vivian-ng/Hardware/README.md

# Hardware

Repository of all hardware related files, including schematics, gerber files, and related software.
