vivian-ng/Hardware/(threads)

Thread 1 (2018-12-12):

Feedback on MRR_ESP_3DP

vivian-ng, 2018-12-12:
Please give any feedback on the board design (schematic and PCB) on this thread.

vivian-ng, 2018-12-13:
@dtony Thank you for the note about SPI, unfortunately, I do not have much experience with TMC2130 drivers, so if you have any information on what are the pins needed and other information on what is needed to drive them, I can try to see how I can fit it in.

vivian-ng, 2018-12-14:
@dtony I did a bit of searching on Google, and I think I have an idea of what it takes to connect the TMC drivers (2130 and 2208, SPI and UART). What I am doing now is adding some jumpers (actually, quite a lot of them) to allow the board to be configured for either TMC2180 SPI mode, TMC2208 UART mode, or just plain simple A4988 drivers.

However, for TMC2130 drivers, they require a separate CS pin for each driver. With the current pinout of the ESP32, there simply isn't enough pins to support 4 TMC2130 drivers running in SPI mode. Two of them (most likely X and Y) can be connected to the I2C pins (SCL and SDA) if you are not intending to use I2C. GPIO0 is also still available, but I am not very sure whether using GPIO0 for output is fine or not, since it is also used for flashing the firmware.

@simon-jouet and @Aggebitter are [talking about using shift registers](https://github.com/simon-jouet/ESP32Controller/issues/4) to increase the number of pins available. This may eventually be the way to go, but meanwhile, for a basic minimum board that can do the bare minimum, this board should be more or less there. I will push out the schematic and gerber files once I have done up the PCB design alterations.

If anyone knows how to convert EasyEDA schematics and PCB designs into KiCad, please let me know. Easier to share the designs in KiCad, which seems to be what everyone is using. I probably should start learning it too.

Aggebitter, 2018-12-14:
@vivian-ng
At last the community is starting to figure out how to use the ESP32 as a 3D printer and as a GRBL CNC machine (https://github.com/bdring/Grbl_Esp32) . At the moment I'm trying to get my small CNC router to work on ESP32 and GRBL. Now I wonder if the two different hardware layouts should be merged to a common layout where the pinout is more or less "standard" for using the easy available RAMPS 1.4 or Protoneer GRBL shields (Arduino UNO shield). I've addressed the "I2S shift register hint" at https://github.com/bdring/Grbl_Esp32 and did a quick'n dirty protoboard for GRBL_ESP32 and RAMPS 1.4.

But Now I feel that I will keep it a bit on hold course the ref design on pinouts  could be merged;)

dtony, 2018-12-14:
@vivian-ng thank you I had not the time to answer to you yet so I am glad that you'd figure it out. Wouldn't it be possible to use the freed pins from A4988 step pin or dir pin to be used as chip select ? I need to look at ESP32 datasheet to be sure but I guess it can be possible. I think keeping the BOM minimal in term of component count is a good idea but you are the captain ;)

vivian-ng, 2018-12-15:
@dtony Thanks for the feedback. From what I understand, whether TMC2130 or TMC2208, whether SPI or UART, the STEP and DIR pins are still needed for actual motor movement control. SPI or UART allows you to set modes, change microstepping, enable stallguard, etc. but they do not allow actual control of the motors. So we are still stuck with needing STEP and DIR pins for each motor.

@Aggebitter and @simon-jouet are working on the I2S shift register feature, which will allow a lot more pins to become available through shift registers. Until that happens, I think we are stuck with the number of pins available for TMC2130 on SPI mode. For TMC2208 on UART, there isn't really much of a problem since it can use the existing TX/RX ports. But I am not sure what will happen when both a host (such as PC) is connected through USB and uses the same TX/RX as the TMC2208...

vivian-ng, 2018-12-15:
@Aggebitter RAMPS 1.4 is a 5V board, so some work will be needed to mod it to allow 3.3V logic. It may be a better idea to develop a 3.3V capable RAMPS equivalent for use with common ESP32 development boards. I think @simon-jouet has done [something like that before](https://github.com/simon-jouet/ESPRamps). Meanwhile, I think I will focus on a basic board, using only the ESP32, no fancy stuff.

Aggebitter, 2018-12-15:
@vivian-ng Vcc hacked to 3.3V of course applied.
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
Found this goodie when I was looking for some proto board pieces. Hmm I'll think I will make it a ESP32 Ramps based on your design and @simon-jouet hopefully soon added shift registers

Aggebitter, 2018-12-17:
@vivian-ng I Did a first quick look into your board design and I'm building a proto/breakout/wire-wrap board based on your design right now. One issue that I noticed is that I prefer to gate MOSFET's with a transistor. This is due the fact that a MOSFET is voltage drive (as charging a capacitor). A well known design flaw in chinese RAMPS 1.4  is MOSFET's that does not open correct when driven in 5V.

A NPN transistor to drive it at higher voltage would be preferred and it will open the range for other MOSFET's as well

One thing that I really would like is a separe voltage line for driving steppers. Driving steppers at higher voltages is an big advantage and just going from 12V to 24 on a 3D-printer does magic. On My small router the difference was huge in speed  as it uses ball screws.

To day newer stepper drivers can handle 40V or more. Goal 36V ?

vivian-ng, 2018-12-17:
@Aggebitter Thank you for the feedback. I have tried to choose mosfets which can be driven by 3.3V logic but I guess driving them at 5V is better, safer, and also more efficient. A question on how to connect these transistors. I am thinking of using a 2N3904, which I guess will be connected with:
base -> HEATER_BED_PIN (and equivalent) in series with a 1K resistor (is this resistor needed?)
collector -> gate of mosfet, after the gate resistor
emitter -> ground
This also means I no longer need a resistor between gate and source of the mosfet, right?
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
As for a separate power rail for stepper motors, I can understand the logic for that, let me think about how feasible it is to add it in, given one of the considerations being to keep the footprint small. Schematic-wise, it is just a matter of connecting VMOT to a separate rail, but adding another terminal may take up more space, and as it is, the current design is barely fitting onto the 100mm by 100mm space.

Aggebitter, 2018-12-17:
I Like the KISS model, Why not just use a MOSFET driver ? here you got a non inverting one:
https://www.microchip.com/wwwproducts/en/TC4427A

Those ones are easy to integrate and will give you good switching times as well

If you go for the transistor way this design will get some ripples but that does not matter for a heater:
http://joost.damad.be/2012/09/dimming-12v-led-strip-with-mosfet-and.html

vivian-ng, 2018-12-17:
@Aggebitter I also like the KISS model. A mosfet driver seems like the easiest and best choice. But how about using a NOR gate, like in the Duet, to drive the mosfets? The Duet uses the 74HCT02.
[https://www.ti.com/lit/ds/symlink/sn74hct02.pdf](https://www.ti.com/lit/ds/symlink/sn74hct02.pdf)

By the way, for my learning, what is the problem with the current design, which is used on most boards that I see?

Aggebitter, 2018-12-17:
@vivian-ng As in open source that we all love there is also often open clone. When China started to manufacture the RAMP 1.4 The started as well to reduce there cost by using cloned parts and the cheapest available kind of replaceable part. One common problem is the MOSFET's. The gate voltage is to low for the MOSFET to open fully. That creates heat at the MOSFET. Ad that it might be a complete different silicon inside of it with the right false marking aka bad clone. This will get really hot and create some hazards.

If You are designing a good 3D controller board, I think a lot of known issues could be addressed and evolve to a better and more safe design. Some things is just for safety and I think a MOSFET driver is one of them. There is a lot of juice flowing over the MOSFET. Over heat and you got a nice PLA fire if printed out a funky box for your controller. Been there done that ;)

danielfmo, 2018-12-18:
Hi, I'm following this project very closely and I'm willing to help with what I can.
I have an Creality Ender 3 that I would love to use my spares ESP32 to replace the controller board.

Sorry for the naive question, but why have the MOSFETs onboard? Would it be preferable/easier/safer to have and external board like this one:
https://www.reprap.me/mks-mosfet-controller.html

danielfmo, 2018-12-18:
Any reason to have different values for R13 and R14? Asking because potentially both VIN and VBED are the same.

vivian-ng, 2018-12-18:
@danielfmo Thanks for showing interest in this project. And also for pointing out the R13 and R14 values. Yes, they should be the same value. Different because they used to be annotated differently (VIN used to be 12V, VBED used to be 24V) but they should both be 2.2K.

As for having an external MOSFET, it is highly recommended if you are going to be driving a lot of current to the heat bed. Still, I want to have a decent MOSFET for the heat bed on the board itself for those who wish to just use a single board, and do not have such high requirements for current. For example, those who are using this with a 12V heat bed should need less than 10A of current, and it helps to have a decent MOSFET to keep the temperature low. Most people use external MOSFETs with Chinese boards because those Chinese boards use poor quality connectors and onboard MOSFETs which then become fire hazards, forcing people to have to buy Chinese-made external MOSFETs (which cost about USD10 more than a decent MOSFET if installed on the board itself). For the Chinese manufacturers, this may help their sales, but as the end consumer, we probably want to strike a balance, keeping price low without compromising safety. Personally, if I am going to drive more than 10A, I will use an external MOSFET just to take the heat off the controller board.

Aggebitter, 2018-12-19:
@vivian-ng I'm wondering about this part :
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

Why not just use IO0 with a pullup ?:
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
It will only make a conflict when uploading firmware, and well no uploading when you are probing

vivian-ng, 2018-12-20:
@Aggebitter I believe Z_MIN is connected to GPIO15. Will that affected uploading of firmware? My understanding is that GPIO0 is the one which needs to be grounded when uploading firmware, which is why I try to avoid using IO0 for anything. But then, it probably doesn't matter, since people are unlikely to be using the printer for anything else when uploading firmware.

If you are referring to using a different pin for the Z probe instead of sharing with Z_MIN, my consideration was that the Z probe is a replacement for Z min endstop anyway, so might as well share the same pin.

Aggebitter, 2018-12-21:
@vivian-ng GPIO15 will not affect firmware upload. I was thinking about using GPIO0 at the probe pin and that would not affect firmware upload as we hopefully will not Z-probe in the same time as we are uploading firmware

Have you thought about making an "Mega/RAMPS" pinout board instead ? Then everyone could easily obtain your controller a RAMPS board and stepper drivers for an easy setup?

I've already builded one proto board that uses RAMPS 1..4 but I'd like to design one later that includes 3.3 to 5V level shifting. That's my learning KiCAD challenge

vivian-ng, 2018-12-21:
@Aggebitter

> Have you thought about making an "Mega/RAMPS" pinout board instead ? Then everyone could easily obtain your controller a RAMPS board and stepper drivers for an easy setup?

That's basically a ESP32 on a MEGA2560 dev board layout. I guess it is not that difficult to design. Just a ESP32 module, a circuit for the CH340, circuit to step down 5V to 3.3V, and level shifters for all GPIO pins. Plus a ton of unused header pins. :sweat_smile:

However, that won't solve the problem with poorly cloned RAMPS boards. Still, it is a good idea, and like you, I may use this as my learning KiCad experience (I want to move away from EasyEDA, which is good but the file format it exports in is not easily readable by other software).

luc-github, 2018-12-21:
@vivian-ng you said put header for Nextion like screen / PanelDue which use rx/tx,
 what happen when an host is also connected to usbserial ?
Does this disable rx/tx like is some others boards ?

Aggebitter, 2018-12-21:
@vivian-ng The unused pins on RAMPS is mostly for screens in an already controller heavy display. If we get the shift register to work we have a lot of unshifted GPIO left on the ESP32 and outputs for servos and everything else

vivian-ng, 2018-12-21:
@luc-github

> what happen when an host is also connected to usbserial ?
> Does this disable rx/tx on header like is done on some others boards ?

Unfortunately, no, all TX/RX takes place on the same two pins, whether they are from USB, AUX1 connector, or TMC2208. Unlike other 32-bit boards, or boards based on the ATMEGA2560, the ESP32 just doesn't have enough pins to support more than 1 set of TX/RX. Of course, this may eventually change if @simon-jouet and @Aggebitter get shift registers to work via I2S as output pins.

@Aggebitter Regarding the idea for use with RAMPS, SparkFun has a [bidirectional level shifter](https://www.sparkfun.com/products/12009) which can help with digital shifting. The idea seems to be two resistors and a transistor, and this circuit is just going to be duplicated for each pin that needs level shifting. However, I am not sure how to go about analog shifting (which I guess is only needed for inputs on VP and VN pins, right?). This ESP32-on-MEGA2560-footprint board probably will have a lot of the space taken up by level shifters, and shift registers (eventually).

Meanwhile, I will focus on getting this basic ESP32-based control board out first. It is not much, but at least it has all the minimum requirements to print something. Will be getting a PCB made soon so that I can solder together something and test it with @luc-github's Marlin fork.

vivian-ng, 2018-12-28:
@Aggebitter I am not very sure how to do this, but I am guessing you mean the signal pin being connected to a voltage divider (any suggestions on the values to use? 10K for both?) as well as a capacitor (100nF?). This is going to be tricky as it will mean adding 6 resistors and 3 capacitors to the board, where space is limited. But I will see what I can do.

As for the suggestion on using transistors, if you have an example diagram of how to do this, it will really help my understanding.

Also, how bad is the noise that you are experiencing? Are the endstops being triggered just be the motors moving?

danielfmo, 2018-12-28:
@Aggebitter why not have the debounce outside of this board/project?

If I understood correctly the goal of this project is to have something that everyone can use to give a try with ESP32. And I'm not aware of other hardware that already have the debounce circuit integrated (3d printing wise).

Off-course that I'm not against it! It's that I think its a very simple circuit that one that needs it can have on an external homemade PCB.

vivian-ng, 2018-12-28:
@Aggebitter
Thank you for the diagram. Can we just do with R3, R4, and Q1? Because [mechanical endstops](https://www.aliexpress.com/item/Endstop-Mechanical-Limit-Switches-3D-Printer-Switch-for-RAMPS-1-4-Free-Shipping-Dropshipping/32434789705.html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,searchweb201602_4_10065_10068_319_10059_10884_317_10887_10696_100031_321_322_10084_453_10083_454_10103_10618_10307_538_537_536,searchweb201603_51,ppcSwitch_0&algo_expid=e3e11c45-5e92-4250-abcd-c34e2cb8b569-1&algo_pvid=e3e11c45-5e92-4250-abcd-c34e2cb8b569) are already being sold with their own debouncing circuits. I guess R1, R2, and C1 will only be necessary if you are just using a plain mechanical switch. Space is an issue, I am trying to keep the circuits simple. Something this elaborate may be functionally great, but my fear is that it will drive the cost of producing it up and make it hard for people to get their hands on one. If the board goes larger than 100mm by 100mm, people cannot make use of cheap PCB services (like the USD2.00 offer from JLCPCB).
The other option I am thinking of is to just have a simple debouncing circuit, with 2 resistors and 1 capacitor, like what is on the Duet. If I do go this way, I will likely use a resistor array to keep the footprint small and see if I can squeeze it in.

@danielfmo
Actually, the Duet, Smoothieboard, and STEVAL-3DP have debouncing circuits on them. They are probably necessary on 3.3V boards using plain mechanical switches as endstops. Chinese boards like the FYTSEC F6 do not have them, but I guess they expect people to use mechanical endstops (with debouncing circuit already built in) with these boards in the first place.
If I cannot fit 3 sets of debouncing circuits on the PCB, I guess I will make a note in the README to use mechanical endstops with built-in circuits.

Aggebitter, 2018-12-28:
@vivian-ng @danielfmo Well, I was thinking when doing 3.3V signaling, that it must have some good filtering and debounce to reduce false triggering. Especially when the steppers are driven at higher voltages. This is cheap and will help a lot

vivian-ng, 2018-12-29:
After looking at the PCB, I think I will add the bare minimum: capacitors as filters for the endstops. The entire setup with more resistors and transistors is probably an ideal state, but it is going to be hard to squeeze into the limited real estate available.
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

Hopefully this is enough to cut down on most of the noise.

Once this basic version is done, I may work on a R2 with this better filter and also incorporate shift registers for additional output IOs. And use smaller SMD parts to make space.

vivian-ng, 2019-01-07:
I finally managed to solder together v0.6 using a frying pan. Flashed the latest version of Luc's Marlin fork, and the web UI is working. Next is to actually connect it to a printer to see if this works. This will take a while since I will be busy over the next few days with work, but I will try to see what I can do to test it out this week.

Meanwhile, v0.7 is already in the works, incorporating the suggestions from everyone. v0.7 will reflect any other changes needed based on testing of v0.6. One update: TMC2208 support will be removed from v0.7 onward as there are not enough sets of TX/RX pins for a meaningful implementation (need 4 pins to implement X and Y at the very least). Maybe when I2S is working and we have more pins available, TMC2208 support will appear again in R2.

vivian-ng, 2019-01-09:
After nearly burning the house down, I realized the LM2596-5.0 was not outputting 5.0V. It was giving more like 5.8V. This caused the 74HCT02 to fail, resulting in voltage being fed continuously to the MOSFETs (one of which I had a hotend attached to).

A few options:
1. Add a 5V regulator to make sure the input to 74HCT02 is always 5V or less.
2. Change to another NOR gate which can accept a higher VCC.
3. Change to a better 5V step-down converter which can provide accurate 5V output.

Option 1 is the easiest, and I will likely be adopting it as I:
a. Do not know any suitable replacements for the 74HCT02 which can handle higher voltages.
b. Do not know any suitable replacements for the LM2596 which can be assured of providing accurate 5V.

If anyone has any better suggestions, please let me know!

Meanwhile, I have removed the 74HCT02 from the board, and used wires to connect the MOSFETs to their respective ESP32 pins.
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

vivian-ng, 2019-01-10:
I think I narrowed down the problem with the high output voltage of the LM2596S-5.0. Stupid me chose the wrong inductor when I was designing on EasyEDA. While the schematic doesn't show it, the inductor being used in v0.6 is rated for a much smaller current (540mA) than recommended. I guess that's why I couldn't get the LM2596S-5.0 to deliver proper 5V. Still, it does expose the flaw of using the 74HCT02 (which can use a max supply of 5.5V) so I will replace that with a 74HCT125.

The next version will likely also include using an opamp to select 5V (either from VIN or VUSB) like on the Arduino UNO R3 board instead of jumpers. Too risky to use jumpers and hope the user remembers to set the jumpers correctly.

dtony, 2019-01-10:
Nice board ! :) What do you think of having jumpers to switch from X, Y or Z endstops to SPI CS_PIN of TMC2130 ? For the extruder controller I don't know which pin could be used as default.

vivian-ng, 2019-01-11:
Just uploaded the files for v0.7. Major changes are the use of 74HCT126 (non-inverting buffer gate) to drive the MOSFETs instead. And a revamp of the 5V step-down circuit to use the TPS54340 instead of the LM2596 for a smaller footprint. The amount of space freed up will eventually be used to add two 74HC595 for I2S driving of the motors (and maybe even MOSFETs).

I will probably order the PCB from JLCPCB again soon and give it another go. Hopefully this design works and I can upgrade it to v1.0 before Chinese New Year, because it is going to be hard to get parts or PCB during Chinese New Year period with all the Chinese companies taking a break. But that also means if I can get v0.7 PCB done by Chinese New Year, I can spend that period testing it and make any necessary (hopefully none) changes.

Aggebitter, 2019-01-19:
@vivian-ng, Simon has the I2S running know so some shift register as the next step ?

vivian-ng, 2019-01-20:
@Aggebitter
Yes, shift register is the next step, but as mentioned, I want to get a version which can just run Marlin 2.0 as it is now. I think I am almost there. v0.8 will be removing 74HCT125 and some headers to make space for 74HC595 registers. The plan is to put two on the board itself (which should be enough to drive 4 steppers), and a breakout of the latch pin to allow connection to a daughter board. The daughter board will include another two 74HC595s plus circuitry to support another 4 steppers.

Why?
This allows people who just need a basic board to use the base board itself. Those who need additional steppers (multi-extrusion, dual Z, etc,) can then have the daughter board option. I already have an idea on how to design the board (components and layout), all I need now is time, and for Marlin to pull Simon's code officially into 2.0 branch.

Meanwhile, let me get a proper v1.0 out first.

vivian-ng, 2019-01-31:
I have renamed the project in preparation for a v1.0 release to give it more identity. Future discussions on the project should be on this [thread](https://github.com/vivian-ng/Hardware/issues/2).

Meanwhile, v0.8 is on KiCad, and the files will be released on GitHub soon.

BTW, v1.0 will still just be a basic board, no I2S. But space has been allocated for I2S, which I will get down to working on once v1.0 is out.

vivian-ng, 2019-09-17:
I have finally managed to find a PCB manufacturer to get a proper quote. I have launched this project on Kickstarter based on the quote to make it available to everyone who wants one but do not have the time/resources to make one themselves. The reward is priced at cost: 76.5% production and shipping, 5% Kickstarter fees, 4.5% Kickstarter payment provider fees, 6% bank fees, 8% taxes.

For those who already have the required components on hand, making your own board by ordering a PCB (from JLCPCB, for example) is the cheaper option. But for those with no such components, I think backing this Kickstarter is the easy (and cheaper) way since the unit price is based on a larger production volume.

Anyway, here is the link:
[MRR ESPA Kickstarter page](https://www.kickstarter.com/projects/maplerainresearch/mrr-espa)

Closed 2019-09-17.

Thread 2 (2019-01-31):

Feedback on MRR ESPA

vivian-ng, 2019-01-31:
Opening a new issue thread to track feedback for the MRR ESPA.

MRR ESPA is the rename of MRR ESP 3DP. The files for MRR ESP 3DP have been migrated to KiCad for v0.8 and those files will be released on GitHub soon. Meanwhile, in preparation for a proper v1.0 release, I have renamed the board to try and give it some identity. :smile:

MRR ESPA v0.9 will be up on GitHub as soon as I can sort it out. File will be on KiCad so that everyone and modify them easily. All symbols and footprints are either from the generic KiCad libraries, or inside a custom library included with the project. You may need to adjust the paths a bit on your system in order to properly find those files. They are in the subdirectory `projlib` with the footprints in `projfp.pretty` and symbols in `projsym.lib`.

The biggest difference between MRR ESPA v0.9 and MRR ESP 3DP v0.8 would be the separation of the VBED rail. It has been isolated from the VIN rail so that they no longer share a common ground line. This means two different PSUs can be used to power VIN and VBED. This is achieved using an optocoupler to drive the bed MOSFET's gate. A voltage divider to half the VBED voltage is the voltage used to drive the MOSFET. I may want to change this to something closer to one-third; but then, it is easily changed by the end user to whatever ratio they want: just solder the corresponding values of resistors instead of the one given in the schematic.

Will upload the files once I can.

vivian-ng, 2019-02-06:
Migrating to KiCad ended up in quite a few mistakes. C11 and C12 of v0.8 were connected wrongly, resulting in 5V not going to the 3.3V LDO, and 3.3V not going to the CH340C. These can be fixed by soldering through-hole capacitors in place of these SMD capacitors. Also, the collector and emitter of the S9014 for Q5 needs to be swapped. Again, this can be done by using a through-hole NPN transistor.

The 5V autoselect circuit also didn't seem to want to work. So I just soldered diodes to prevent backflow.

After making these changes (capacitors C11 & C12, Q5, and the diodes to VUSB and 5V1), the board works! However, because IO2 is pulled high, the board cannot be flashed solely with USB. I needed to connect IO2 to GND (via the header pins), reset the board to enter flash mode. Once that is done, the board can be flashed. The next step is to test the motors and MOSFETs. Hopefully, I don't burn anything.

vivian-ng, 2019-02-18:
I am having some issues trying to compile Marlin 2.0 with TMC2130 for X and Y axes.

`In file included from /tmp/arduino_build_501088/sketch/src/module/../inc/MarlinConfig.h:45:0,
                 from /tmp/arduino_build_501088/sketch/src/module/configuration_store.h:26,
                 from /tmp/arduino_build_501088/sketch/src/module/configuration_store.cpp:47:
/tmp/arduino_build_501088/sketch/src/module/configuration_store.cpp: In function 'void say_M906()':
/tmp/arduino_build_501088/sketch/src/module/configuration_store.cpp:1926:52: error: 'port' was not declared in this scope
     void say_M906(PORTARG_SOLO) { SERIAL_ECHOPGM_P(port, "  M906"); }
                                                    ^
/tmp/arduino_build_501088/sketch/src/module/../inc/../core/serial.h:81:69: note: in definition of macro 'SERIAL_PROTOCOLPGM_P'
   #define SERIAL_PROTOCOLPGM_P(p,x)               (serialprintPGM_P(p,PSTR(x)))
                                                                     ^
/tmp/arduino_build_501088/sketch/src/module/configuration_store.cpp:1926:35: note: in expansion of macro 'SERIAL_ECHOPGM_P'
     void say_M906(PORTARG_SOLO) { SERIAL_ECHOPGM_P(port, "  M906"); }`

I am not really sure how to fix this on Marlin, don't even know if Marlin 2.0's TMC2130 support can even run on the ESP32, so I will leave the hardware option available for the time being while someone eventually works out a software solution to it. Meanwhile, the TMC2130 support on this board will continue to be listed as "Untested" so that people know it is something to be implemented software-wise.

vivian-ng, 2019-03-04:
Update on v0.9.

Soldered everything, and compiled @luc-github Marlin fork which has his ESP3D interface. Prelim tests show that the compile went okay, I could drive the motors to move using the webUI. I attached a heating block with thermistor to simulate the heat bed, and it was able to heat up too, so at least the optocoupler seems to be working. E0 also heated up.

Only thing that seems to be the problem is AUX1. I can't seem to get my MKS TFT32 to work with the board via AUX1. And in the process, I think I fried my RX and TX pins on the ESP32... so while I can see serial messages on the webUI, I can no longer connect to the board with a wired connection (USB or USB<->Serial module) to see serial messages.

Next step is to find time to wire v0.9 to an actual printer to try some test prints, as well as a stress test (dry-print something for 24 hours or more) if the test prints come out okay. Once everything is working, then I will go back to troubleshooting the MKS TFT32 connection (which probably means I need to solder a new board; good thing I ordered 5 pieces).

Meanwhile, v0.9 files will be released soon. It will be accompanied by a sorting of the directory structure, so let me think through the new directory structure first.

vivian-ng, 2019-03-18:
Update on v0.9.

The files have been uploaded to the repo under the `current` directory.

Theoretically, v0.9 works as long as you are using external MOSFETs for the bed and hotend. During my testing, I discovered that the traces for the bed and hotend MOSFETs were too thin and also the via connecting top and bottom traces were too small. This causes heat buildup, melts the PCB, and gives off smoke. Not a great thing to do. But with external MOSFETs, the current is taken off the board, so the design works as it is.
BTW, if anyone wants to try out v0.9 using external MOSFETs, you can do away with the bed and hotend MOSFETs onboard to save cost. Just use jumper wires to connect IO2 (hotend), IO4 (bed), and GND (can take from AUX1) to their respective external MOSFETs. Of course, you can leave them in and still use them to drive the external MOSFET.

Also tested motor movement using A4988 drivers, which worked fine. I had issues compiling the webui-enabled Marlin fork by @luc-github using TMC2130 drivers, as mentioned above, but when I used the latest bugsfix-2.0.x from the main Marlin repo, I could compile TMC2130 support with no issue using the [TMCStepper library](https://github.com/teemuatlut/TMCStepper). So theoretically, TMC2130 in SPI mode should work too, although I will need to find time to test this (eventually...)

Also theoretically, TMC2130 and TMC2208 drivers should work in standalone mode if the jumpers underneath the stepstick are removed (MS1 and MS2 must both be tied to VIO to enable 1/16 microstepping). I just ordered two each and will test them when they arrive in a few weeks time.

Way ahead:
I am working on the MOSFET trace issue, and will work on the TMC2130/TMC2208 jumpers to allow them to be used for standalone mode (same 3-pin jumpers, with connections to GND and VIO). The next version of this board will not have the current "use jumpers to configure for TMC2130 SPI" feature. SPI pins are already exposed, so future versions of this board will support standalone mode via jumpers, and SPI mode with the "top-facing pins" method used in most other boards.

The next version of this board should be the "production" version. Once it is done and tested to be respectably working fine, I am going to move to add the I2S support. But will need to check with @simon-jouet on what his I2S setup is like.

daboi, 2019-04-12:
Hi @vivian-ng, any updates on simon-jouet's I2S support. Would like to make a board with ESP32 but I guess simon was not able to look further into this. I would like to contribute if I can.

simon-jouet, 2019-04-12:
Hey @daboi @vivian-ng,

Yeah I've been far too busy with work, to prototype the ESP32 i2s board, I've got the basic schematic of it done quite some time ago, I just need time to tweak it and layout the PCB (which is very very time consuming).

I2S does work very well for printing, I've used it with the existing R1 prototype board and some breadboard for some time and didn't run into any issues.

daboi, 2019-04-12:
Hey @simon-jouet! Wasn't expecting fast reply, thanks! Great approach on esp32 btw. I read almost all of your posts on github. Do you have a repo for the latest pcb so that I may have contribute to that?

simon-jouet, 2019-04-12:
@daboi it's a bit hit and miss depends if I have to reply or not when I get the email from github :D. Thanks, glad to hear that, I'm still convinced that the ESP32 is the best way to get a very good and cheap controller.  The updated PCB isn't on github yet considering it still needs work, but I can try to push it to a new branch in the weekend so you (and anybody else interested) can have a look/contribute

daboi, 2019-04-12:
I subscribed almost all topics about this so will keep me up-to-date :)  Happy to hear that. Which repo will you be using for branch?

vivian-ng, 2019-04-12:
@simon-jouet I just managed to finish soldering the latest version of my own board, which hopefully will solve my burning (literally) issues. Trying to find time to test out the board over the next week. Testing with 12V doesn't really help since it is double the current to get the same power compared to using 24V. Also, I managed to figure out the pins for the I2S from the code:
22 DATA_OUT
25 WS_OUT
26 BCK_OUT

Once the current basic board is tested working, I am going to add two 74HC595s to the board (already got the empty space on the board to place those two ICs; other than capacitors on their VCCs, is there anything else that they will need?) to drive the existing 4 stepper drivers. This should free up enough pins for me to experiment with using those pins for UART/SPI_CS with TMC drivers.

simon-jouet, 2019-04-12:
> I subscribed almost all topics about this so will keep me up-to-date :) Happy to hear that. Which repo will you be using for branch?

my ESPController repo most likely, I can post here once it's done (just need to remember to do it)

@vivian-ng well done hopefully your testing goes well. Yeah the pins for I2S don't really matter too much as they can be remapped so in the current version I used pins that don't have too many functions (but I should double check because it's a bit hard to remember everything). IIRC there is no need for anything else no, what might be good would be to select whether the 74HC595 are powered by 3.3V or 5V so we can get the speed benefits of 5v if needed but 3.3V for instance if it's used as a reference for a signal back in the ESP32 as it's not 5v tolerant.

daboi, 2019-04-12:
@simon-jouet can we upload gcode file to esp32 from web interface? I saw esp3D repo has that webui but can it work with your implementation? also is it possible to plug an sd card port ? I guess you stream gcode from usb port right? Btw thanks for all info, I am hoping to be a tester of your work =)

vivian-ng, 2019-04-12:
@daboi I am using the ESP3D-enabled Marlin fork that @luc-github is working on. It works on my test board (ESPA v0.9). v0.9 can work if external MOSFETs are used to take the current off the board; v1.0 will have larger tracks and hopefully eliminate the need for external MOSFETs.

daboi, 2019-04-12:
@vivian-ng thanks for the info. That fork has common code with @simon-jouet's one? I am trying to understand which repo contains which part so sorry for asking in detail. Will you branch from @luc-github's work and add I2S option?  I can definitely try your V1.0 board design.

vivian-ng, 2019-04-12:
@daboi The fork that @luc-github is working on is based on Marlin bugsfix-2.0.x, which already has I2S implemented by @simon-jouet. I had to figure out the I2S pins from the code because he hardcoded it inside the I2S.cpp file. Maybe if he decides to update the code subsequently, he can consider putting the #defines for those pins in a pins file.

daboi, 2019-04-12:
@vivian-ng thanks for the clarification. So I will be watching your and @simon-jouet's repos and will start to test at some point :) Thanks for the work you guys have done.

simon-jouet, 2019-04-13:
@daboi @vivian-ng here it is https://github.com/simon-jouet/ESP32Controller/tree/r2 I should have most of the components to prototype that one too, just need to find the time and motivation to layout the PCB (and design the footprints and models for some components...)

vivian-ng, 2019-04-17:
Tested the board. Partially.

Motors with A4988 drivers working. Endstop working. Hotend was able to heat up to 240 degC and maintain it without any significant rise in the temperature of the MOSFET. So far so good...

And then, when I tried to heat the bed... that was when things got really interesting. Tried room temperature to 40 degC, and saw smoke when it started to heat up to 35 degC. Temperature on the heatsink attached to the MOSFET was reaching 120 degC. Shut off, then I tried gradual heating. Slowly when from room temperature to 35, then step up in steps of 2 to 3 degC. Eventually reached 50 degC. When going to 52 degC, there was a bit of smoke which soon stopped when temperature reached target. Then I tried 55 degC. That was when it started to smoke real bad. Like, things were melting, there was sizzling sound, and lots of smoke. Quickly shut off the mains.

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

As you can see, there is a black melted part at the heat bed MOSFET (IRLS3034). Problem is, I cannot figure out why.

The heat bed is 180W, running on 12V, so the current draw (theoretically) is 15A. The MOSFET is driven by a voltage divider that drives the gate at 4.8V. Based on specs, the IRLS3034 should have Rds of 2.0 mOhms at 4.5V. So simple calculation says the MOSFET is dissipating 15x15x0.002 which is 0.45W. At temperature rise of 40degC/W, the MOSFET should only be rising like 18degC. I mean, even given other factors, the temperature rise should not be more than 50degC, right? But I was getting a temp rise of 100degC and more. I can't really figure out why.

Anyway, I will be testing it subsequently with an external MOSFET just to see if I can get something to print.

vivian-ng, 2019-05-18:
Update on the IRLS3034 MOSFET issue. Ordered IRLS3034 from Mouser, and soldered together another board.
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
The one on top is the Mouser one, the one below is the Aliexpress one.

And I finally found time to hook up the board and give it a quick test.
And the Mouser one... works.
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
I managed to heat up the heat bed to 70 degC without the MOSFET burning. Without a heat sink on the MOSFET, the temperature of around the MOSFET went to around 110 degC. With that blue heat sink, it kept below 85 degC. Still, the area near the 20A fuse was registering temperatures above 100 degC. I am not sure if the rise in temperature was due to the fuse. This was when I was heating a heat bed at 12V, likely drawing around 15A.

Lesson: Some components can be bought from Aliexpress. But for critical parts (high current stuff, or when very precise values are needed), go for a distributor like Mouser and Digikey.

vivian-ng, 2019-05-21:
There is a new ESP32 module being released, the [ESP32-S2](https://www.espressif.com/en/news/espressif-announces-%E2%80%A8esp32-s2-secure-wi-fi-mcu).
Apparently, it will be cheaper than the current ESP32, and it will come with USB OTG! There are [some features being taken out](https://www.esp32.com/viewtopic.php?f=2&t=10632), though.

Still, having USB may mean there is no longer a need for the CH340, which will help to reduce the footprint a little.

luc-github, 2019-05-21:
single core will impact wifi usage / printing

vivian-ng, 2019-05-28:
I changed the 20A fuse to a Bel 20A 0679L series fuse that I got from Mouser, but there is still a significant temperature rise around the fuse area. Reaches about 140degC when the bed is heating up... but at least nothing is melting away. Still, I think that is because I am using the fuse at quite near its rating; the bed is drawing around 15A, and I should probably be using a 30A fuse (or maybe even 40A) instead of a 20A fuse. A 20A fuse will definitely work for lower currents when using a 24V supply (assuming power rating of the bed remains the same; using a 24V supply on a 12V heat bed will result instead in a current draw of around 30A!!!)

So I am going to swap out the 20A fuse for a 30A one in the next iteration. Which, by the way, will have I2S.

vivian-ng, 2019-06-23:
I believe I have sorted out the board overheating issues. It has to do with the trace widths for the VBED lines.

For the v1.0 board, I actually just soldered two pieces of copper wire from the terminals to the fuse.
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

For v1.01 board, I changed the layout a bit to allow traces to the fuse from both upper and lower layers. This allowed the board to stay below 100degC when heating the heat bed @12V (around 15A current). I used a thermocouple to measure the fuse temperature, it registered around 85 degC so it seems to be okay.
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

v1.0 board works well with 24V, tried it on my Ender-3.
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

Obviously, not the best in print quality, but I haven't done any tuning. All I did was use the M503 settings from the original Ender-3 board, and just entered them into the v1.0 board. Still, mesh bed leveling data survived and seemed to be working quite well.

vivian-ng, 2019-09-17:
I have finally managed to find a PCB manufacturer to get a proper quote. I have launched this project on Kickstarter based on the quote to make it available to everyone who wants one but do not have the time/resources to make one themselves. The reward is priced at cost: 76.5% production and shipping, 5% Kickstarter fees, 4.5% Kickstarter payment provider fees, 6% bank fees, 8% taxes.

For those who already have the required components on hand, making your own board by ordering a PCB (from JLCPCB, for example) is the cheaper option. But for those with no such components, I think backing this Kickstarter is the easy (and cheaper) way since the unit price is based on a larger production volume.

Anyway, here is the link:
[MRR ESPA Kickstarter page](https://www.kickstarter.com/projects/maplerainresearch/mrr-espa)

@luc-github Please do not back this project. I will send one board to you if the project is successful.

luc-github, 2019-09-21:
@vivian-ng I have added link to the kickstarter in my Fork's readme

vivian-ng, 2019-09-21:
@luc-github Thank you for the support! Hopefully, the funding goal can be reached. I probably should be trying to advertise the Kickstarter project more aggressively but I don't want to oversell this since it is a community effort and my purpose is just to get it to people who are interested, and not to make people interested.

luc-github, 2019-09-21:
you do not need to oversell, just communicate project exists - IMHO some communication would be good  as not so many  esp32 boards available there for not electronician guys

vivian-ng, 2019-11-13:
I have made the [MRR ESPA](https://github.com/maplerainresearch/MRR_ESPA) v1.3 (non-I2S version) available [here](https://www.maplerain.com/en/products/mrr-espa-prelaunch), and the [MRR ESPE](https://github.com/maplerainresearch/MRR_ESPE) v0.5 (I2S version) [here](https://www.maplerain.com/en/products/mrr-espe-prelaunch) for those who wish to try one without having to get all the parts and solder everything by yourself.

I have been using the non-I2S version for quite a while now and it has been running quite smoothly. My printer is located a distance away from my PC, so while I usually control my printer via the PC, I have an unused smart phone near the printer to let me control the printer from nearby too (such as when doing manual mesh bed leveling or loading filament).

As for the I2S version, I think the board is ready, as it is now, in terms of the hardware. Software support still depends on Marlin development, and I did experience random freezes in the past when using I2S, so I cannot say it is the most stable. I also experienced resets when used with a LCD controller, but recent fixes to the Marlin code seemed to have fixed that. Still, I would say the I2S version is still in the experimental stages in terms of firmware. If stable operation is more important, the MRR ESPA (non-I2S version) is the better option.
