vivian-ng/Hardware/MRR_ESPA/old/v0.7/Schematic_MRR_ESP_3DP_v0.7.pdf

Stepper drivers | Endstops

## Heater: Bed

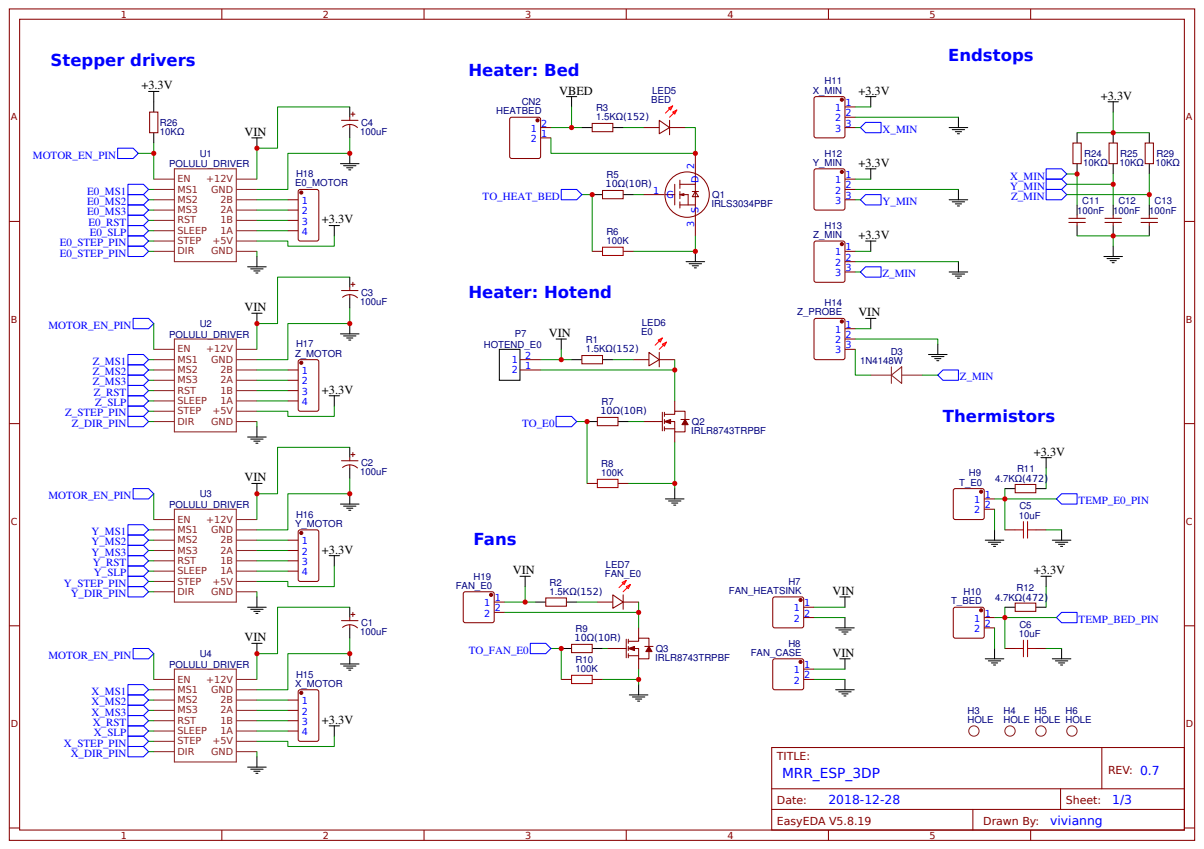
[picture p1: page 1]

IO0 25 IO4 26 IO16 27 IO17 28 IO5 29 IO18 30 IO19 31 NC 32 IO21 33 RXD0 34 TXD0 35 IO22 36 IO23 37 GND 38

## LEDs

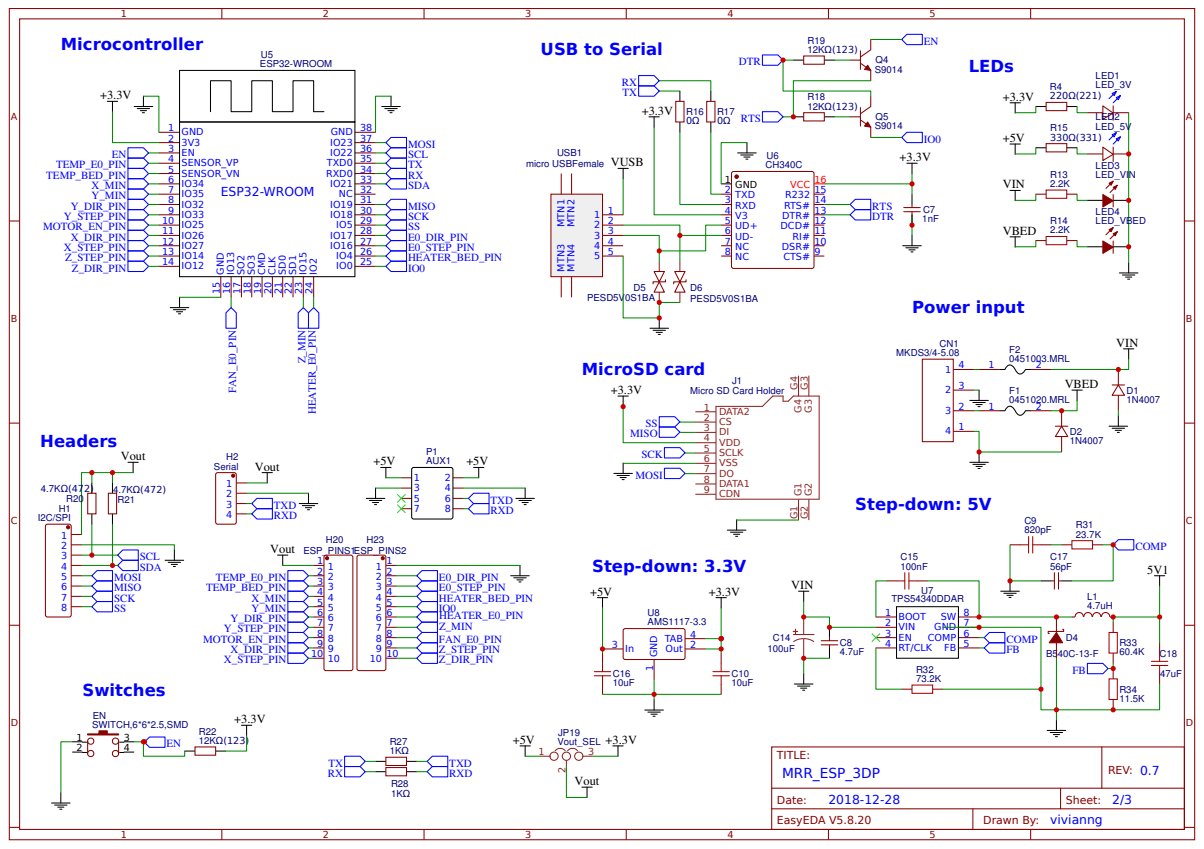
[picture p2: page 2]

USB1 MTN³ MTN⁴ MTN¹ MTN²
micro USBFemale

## Stepper driver jumpers

## 5V select

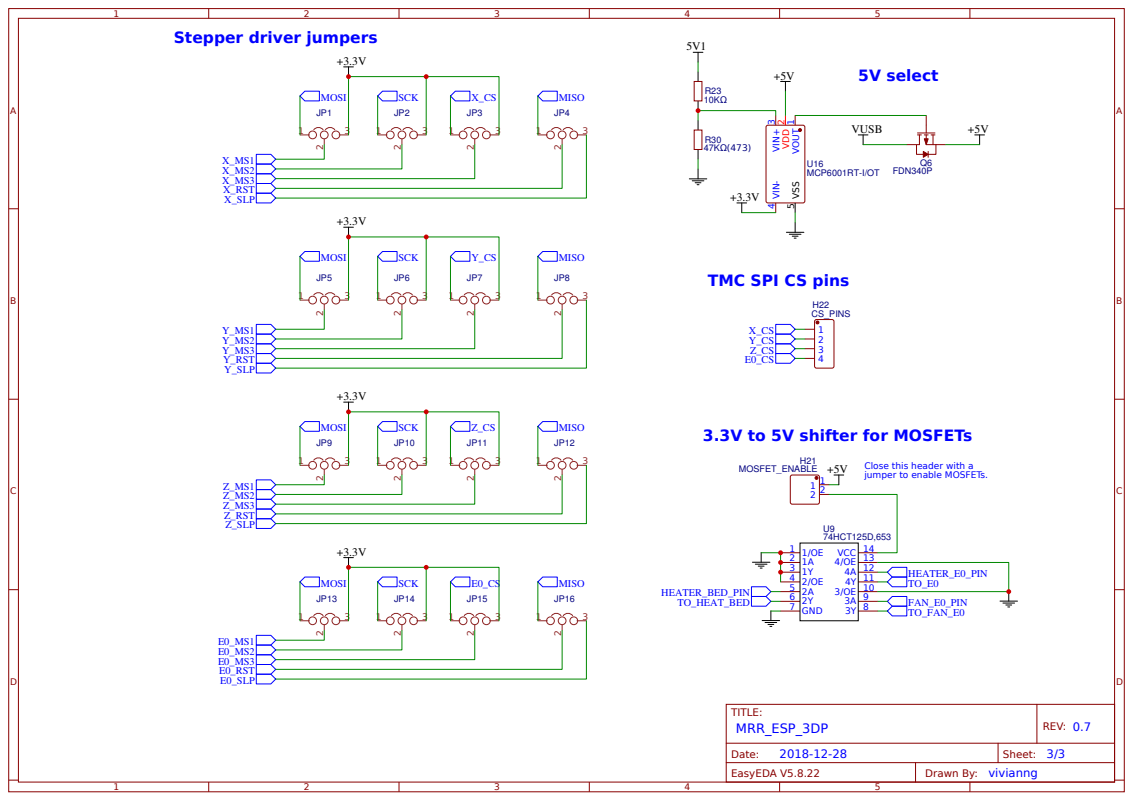
[picture p3: page 3]

VOUT 1 VDD 2 VIN+ 3 VIN- 4 VSS 5

TMC SPI CS pins

3.3V to 5V shifter for MOSFETs

Close this header with a
jumper to enable MOSFETs.
