vivian-ng/Hardware/MRR_ESPA/old/v0.6/Schematic_MRR_ESP_3DP_v0.6.pdf

Stepper drivers | Endstops

## Heater: Bed

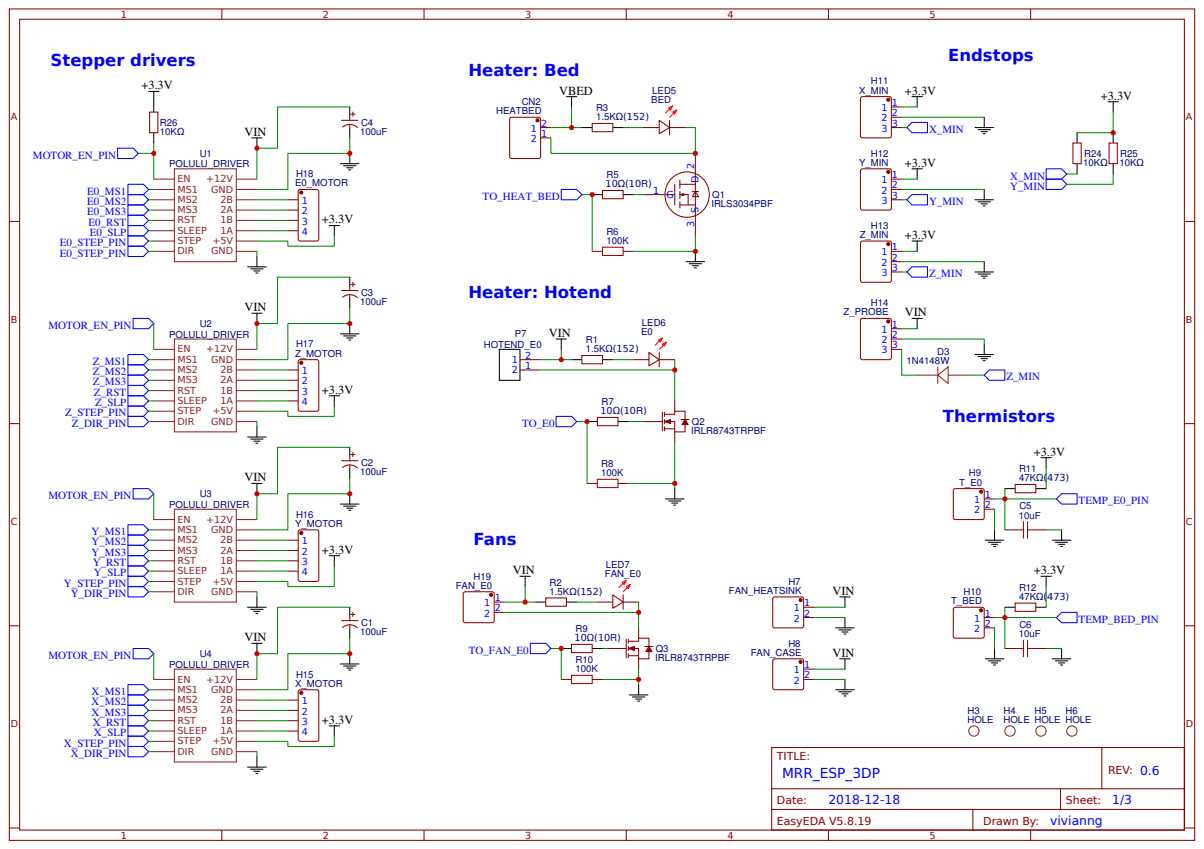
[picture p4: page 1]

IO0 25 IO4 26 IO16 27 IO17 28 IO5 29 IO18 30 IO19 31 NC 32 IO21 33 RXD0 34 TXD0 35 IO22 36 IO23 37 GND 38

## LEDs

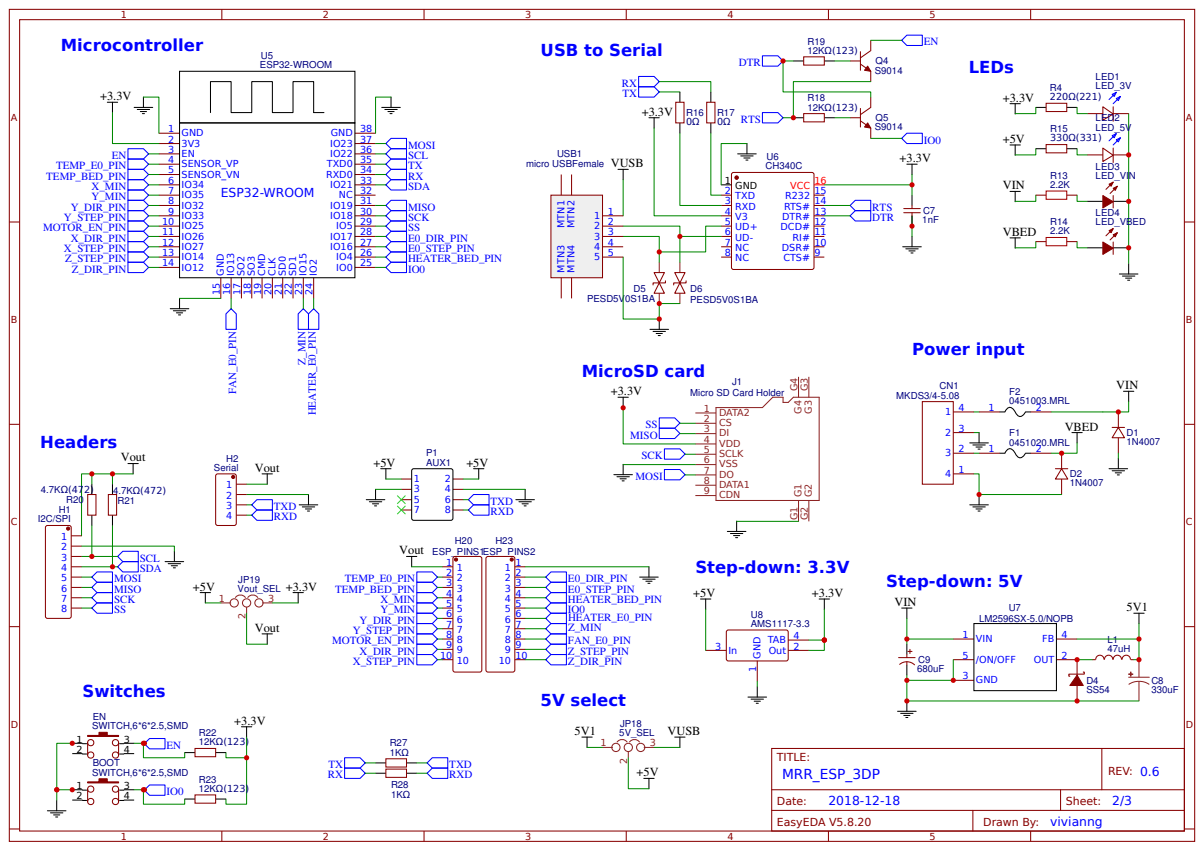
[picture p5: page 2]

USB1 MTN³ MTN⁴ MTN¹ MTN²
micro USBFemale

Stepper driver jumpers | TMC driver: SPI / UART select

## TMC SPI CS pins

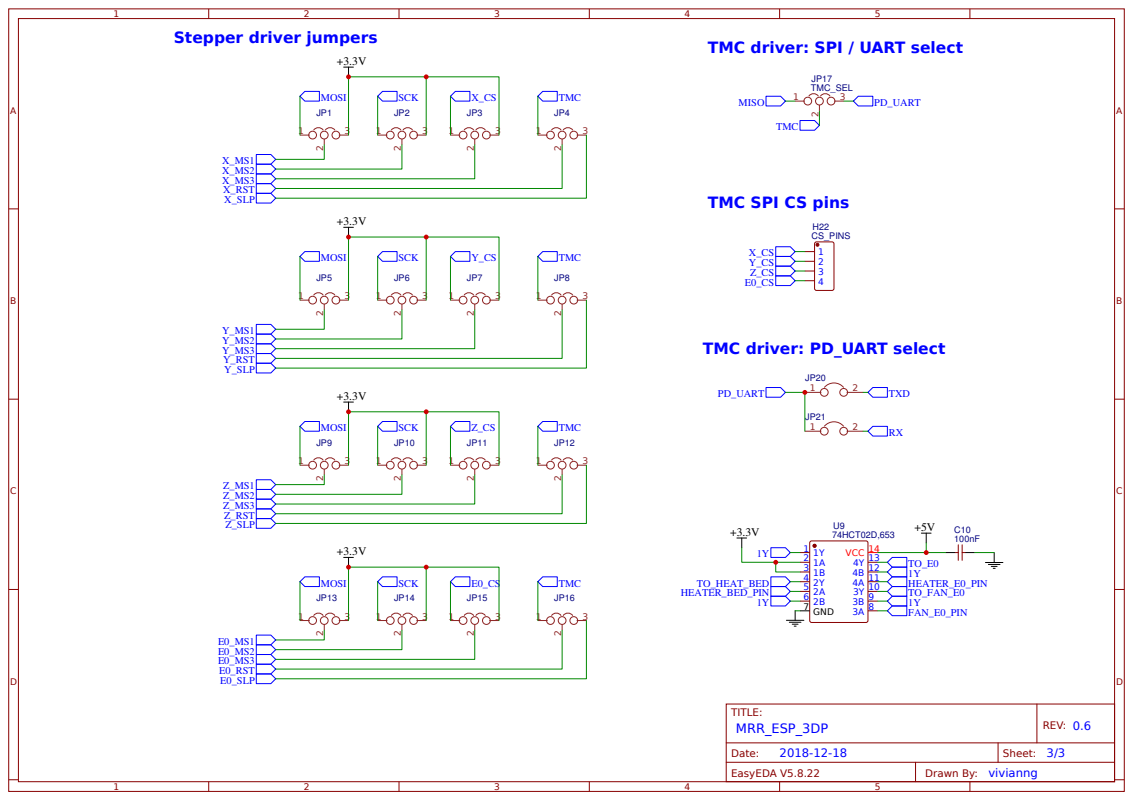
[picture p6: page 3]
