vivian-ng/Hardware/MRR_ESPA/old/v0.4/Schematic_MRR_ESP_3DP_v0.4.pdf

## VBED

## VIN

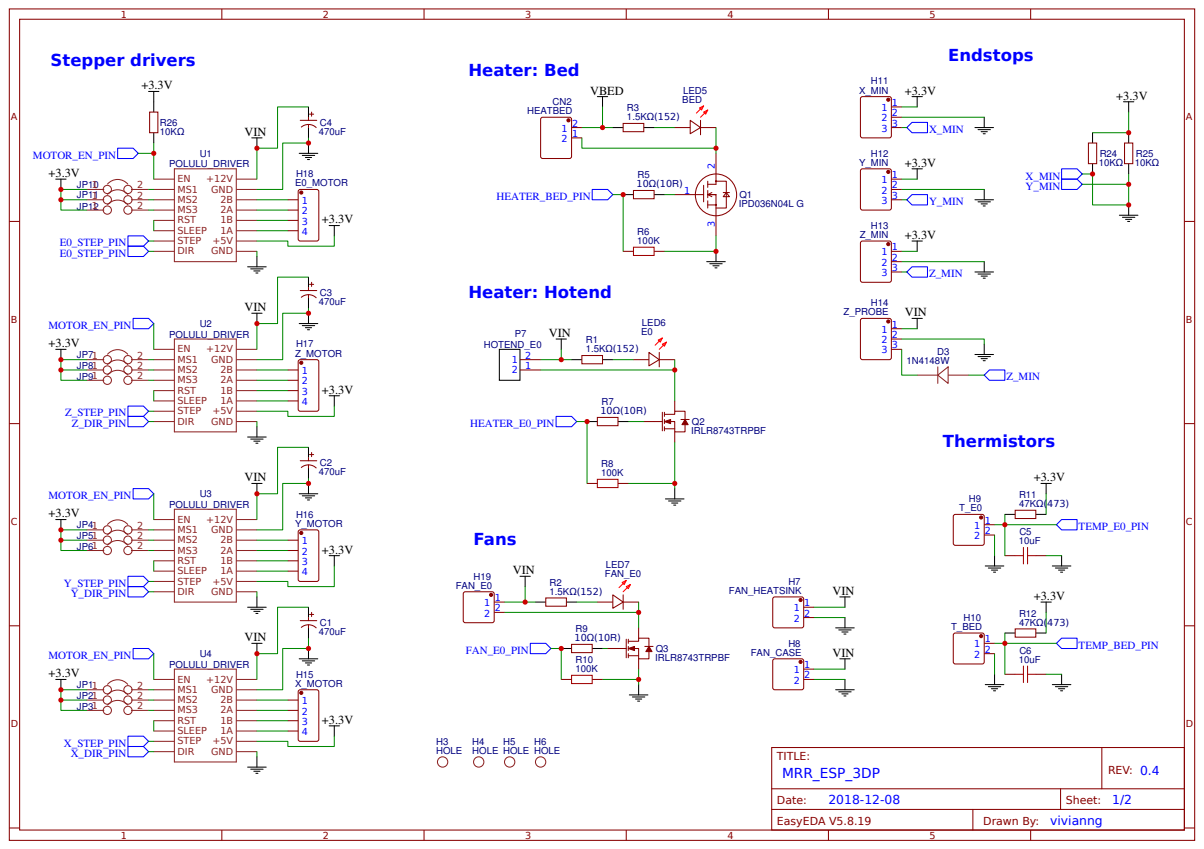
[picture p10: page 1]

+3.3V
IO0 25 IO4 26 IO16 27 IO17 28 IO5 29 IO18 30 IO19 31 NC 32 IO21 33 RXD0 34 TXD0 35 IO22 36 IO23 37 GND 38

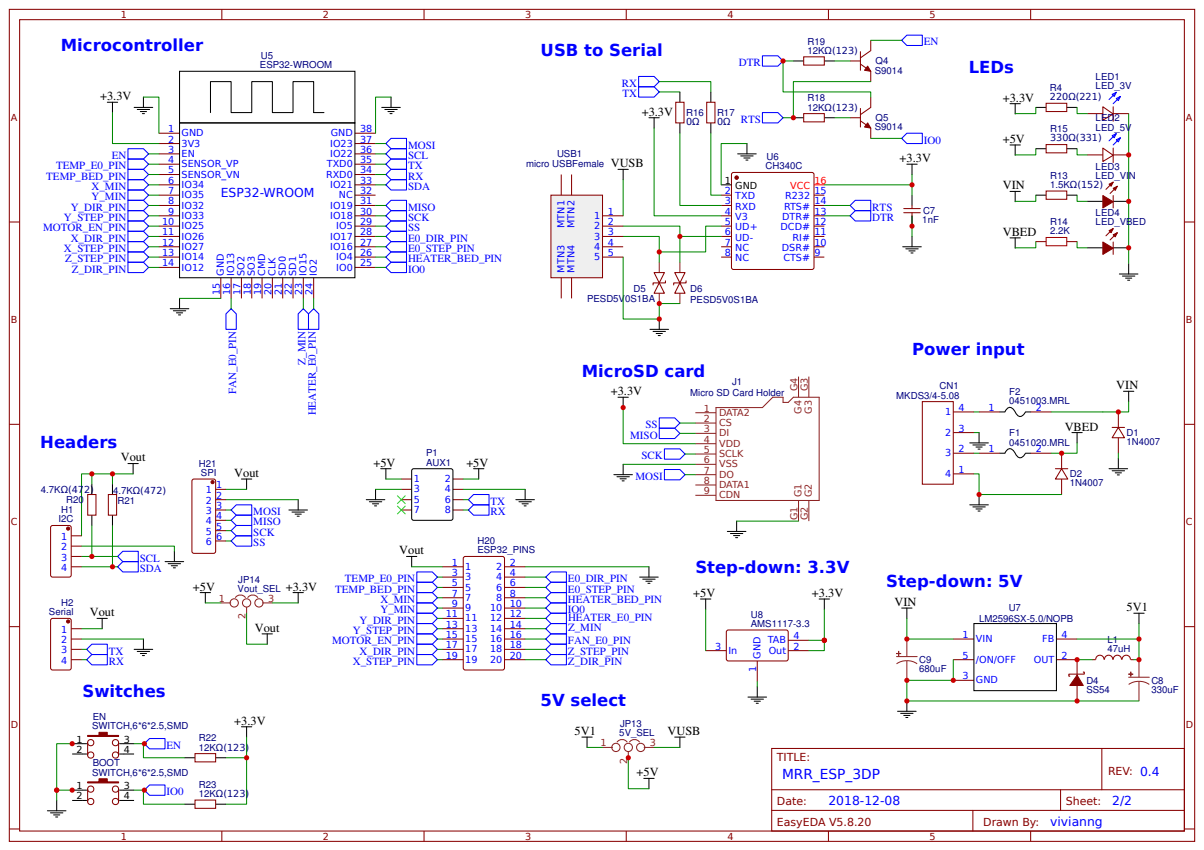
[picture p11: page 2]

USB1 MTN³ MTN⁴ MTN¹ MTN²
micro USBFemale
