vivian-ng/Hardware/MRR_ESPA/old/v0.5/PhotoView_PCB_MRR_ESP_3DP_v0.5.pdf

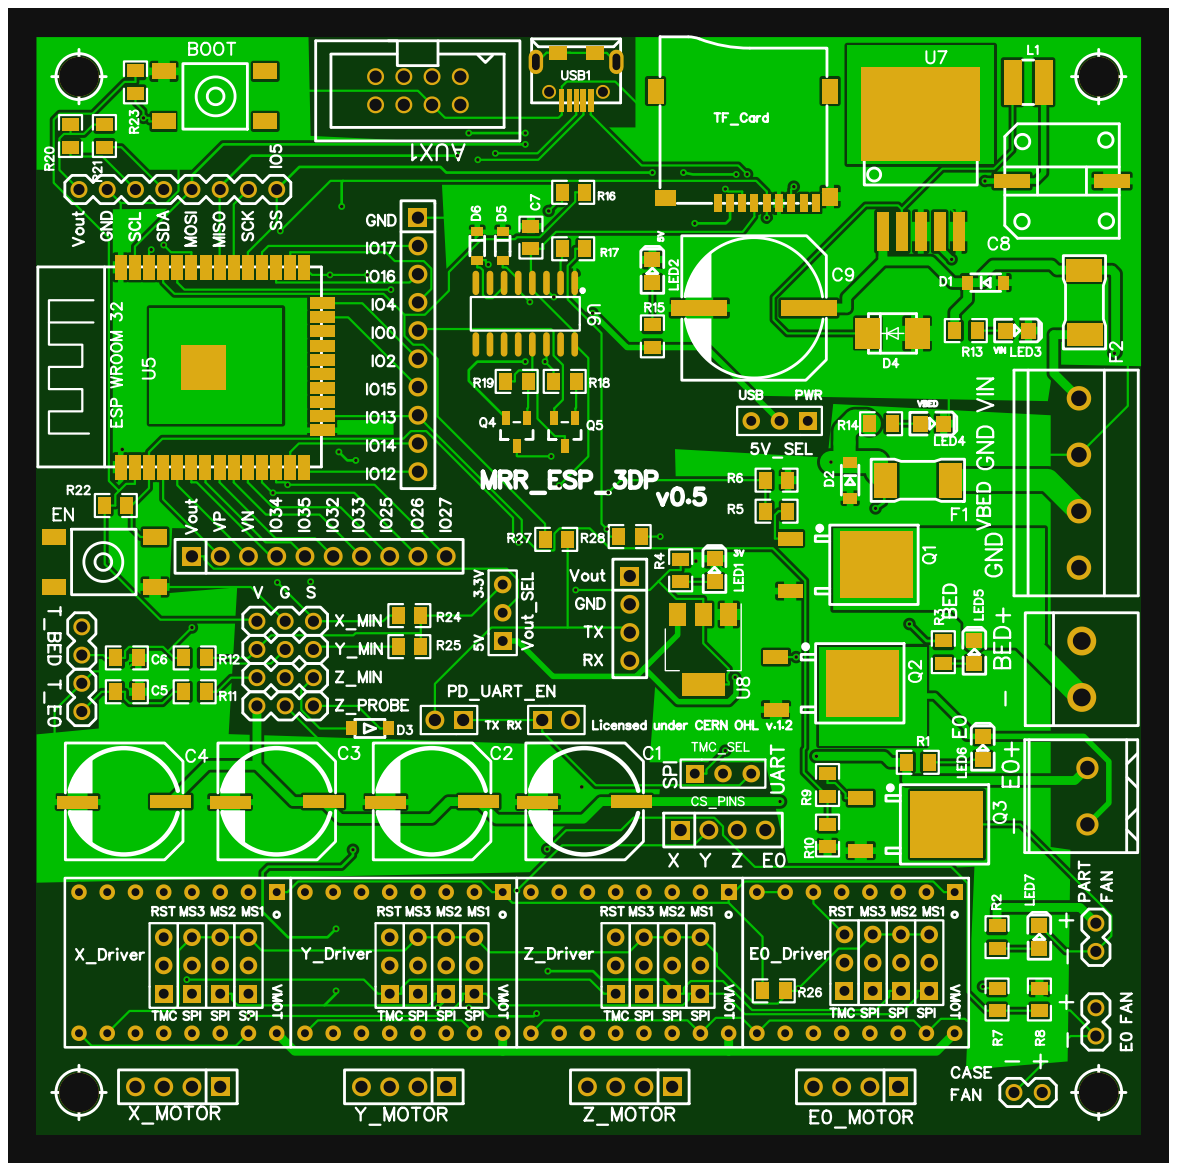
[picture p12: page 1]
