vivian-ng/Hardware/(list of files, drawings)

Other design files:
MRR_ESP_3DP/PCB_ESP32_3DP_v3.pcbdoc
MRR_ESPA/old/v0.4/PCB_MRR_ESP_3DP_v0.4.pcbdoc
MRR_ESPA/old/v0.5/AltiumPCB_MRR_ESP_3DP_v0.5.pcbdoc
MRR_ESPA/old/v0.6/PCB_MRR_ESP_3DP_v0.6.pcbdoc
MRR_ESPA/old/v0.8/MRR_ESP_3DP.dsn
MRR_ESPA/v0.4/PCB_MRR_ESP_3DP_v0.4.pcbdoc
MRR_ESPA/v0.5/AltiumPCB_MRR_ESP_3DP_v0.5.pcbdoc
MRR_ESPA/v0.6/PCB_MRR_ESP_3DP_v0.6.pcbdoc
MRR_ESPA/v0.8/MRR_ESP_3DP.dsn
