vivian-ng/Hardware/MRR_ESPA/current/MRR_ESPA.kicad_pcb

## KiCad design MRR_ESPA/current/MRR_ESPA.kicad_pcb (2019-06-20)

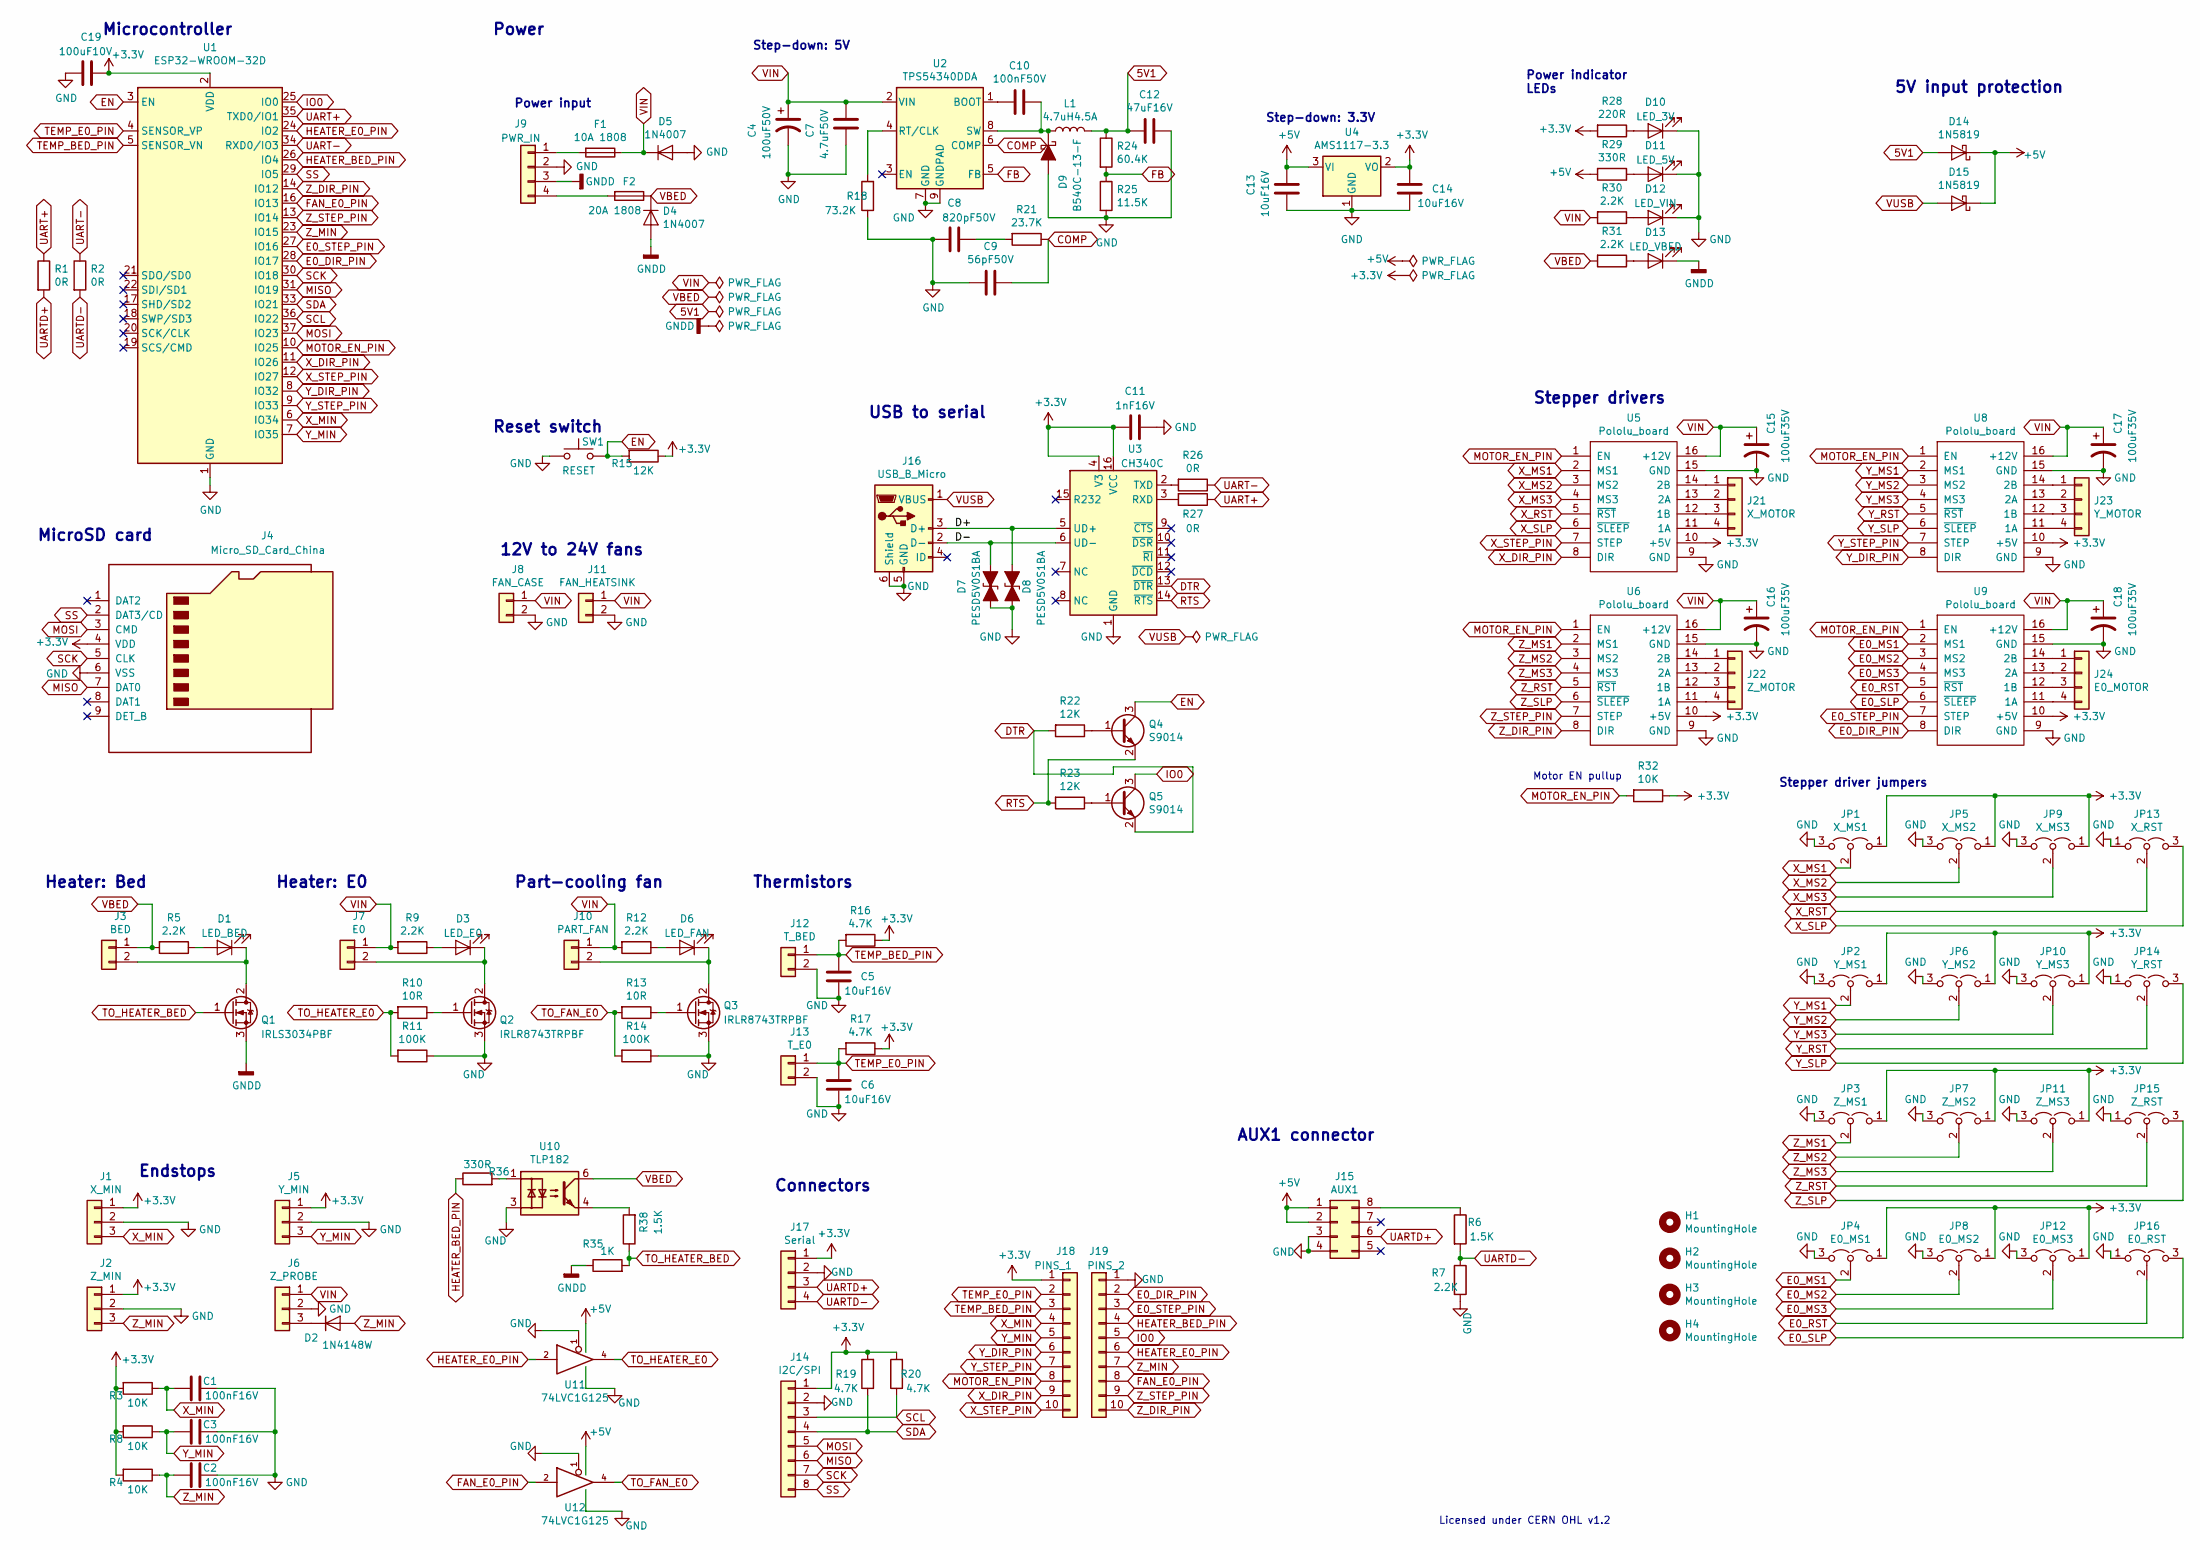
[picture p13: schematic MRR_ESPA.sch, MRR ESPA]

Parts:
C1, C2, C3: 100nF16V; C_0805_2012Metric
C4: 100uF50V; CP_Elec_8x10
C5, C6, C13, C14: 10uF16V; C_0805_2012Metric
C7: 4.7uF50V; C_1206_3216Metric
C8: 820pF50V; C_0805_2012Metric
C9: 56pF50V; C_0805_2012Metric
C10: 100nF50V; C_0805_2012Metric
C11: 1nF16V; C_0805_2012Metric
C12: 47uF16V; C_1206_3216Metric
C15, C16, C17, C18: 100uF35V; CP_Elec_6.3x7.7
C19: 100uF10V; C_1206_3216Metric
D1: LED_BED; LED_0805
D2: 1N4148W; D_SOD-123
D3: LED_E0; LED_0805
D4, D5: 1N4007; D_SOD-123F
D6: LED_FAN; LED_0805
D7, D8: PESD5V0S1BA; D_SOD-323
D9: B540C-13-F; D_SMC
D10: LED_3V; LED_0805
D11: LED_5V; LED_0805
D12: LED_VIN; LED_0805
D13: LED_VBED; LED_0805
D14, D15: 1N5819; D_SOD-123
F1: 10A 1808; Littelfuse_0451
F2: 20A 1808; Littelfuse_0451
H1, H2, H3, H4: MountingHole; MountingHole_3.2mm_M3_DIN965
J1: X_MIN; PinHeader_1x03_P2.54mm_Vertical
J2: Z_MIN; PinHeader_1x03_P2.54mm_Vertical
J3: BED; TerminalBlock_Phoenix_MKDS-3-2-5.08_1x02_P5.08mm_Horizontal
J4: Micro_SD_Card_China; Conn_uSDcard
J5: Y_MIN; PinHeader_1x03_P2.54mm_Vertical
J6: Z_PROBE; PinHeader_1x03_P2.54mm_Vertical
J7: E0; TerminalBlock_Phoenix_MKDS-1,5-2-5.08_1x02_P5.08mm_Horizont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
J8: FAN_CASE; PinHeader_1x02_P2.54mm_Vertical
J9: PWR_IN; TerminalBlock_Phoenix_MKDS-3-4-5.08_1x04_P5.08mm_Horizontal
J10: PART_FAN; PinHeader_1x02_P2.54mm_Vertical
J11: FAN_HEATSINK; PinHeader_1x02_P2.54mm_Vertical
J12: T_BED; PinHeader_1x02_P2.54mm_Vertical
J13: T_E0; PinHeader_1x02_P2.54mm_Vertical
J14: I2C/SPI; PinHeader_1x08_P2.54mm_Vertical
J15: AUX1; IDC-Header_2x04_P2.54mm_Vertical
J16: USB_B_Micro; USB_Micro-B_Molex-105017-0001
J17: Serial; PinHeader_1x04_P2.54mm_Vertical
J18: PINS_1; PinHeader_1x10_P2.54mm_Vertical
J19: PINS_2; PinHeader_1x10_P2.54mm_Vertical
J21: X_MOTOR; PinHeader_1x04_P2.54mm_Vertical
J22: Z_MOTOR; PinHeader_1x04_P2.54mm_Vertical
J23: Y_MOTOR; PinHeader_1x04_P2.54mm_Vertical
J24: E0_MOTOR; PinHeader_1x04_P2.54mm_Vertical
JP1: X_MS1; PinHeader_1x03_P2.54mm_Vertical
JP2: Y_MS1; PinHeader_1x03_P2.54mm_Vertical
JP3: Z_MS1; PinHeader_1x03_P2.54mm_Vertical
JP4: E0_MS1; PinHeader_1x03_P2.54mm_Vertical
JP5: X_MS2; PinHeader_1x03_P2.54mm_Vertical
JP6: Y_MS2; PinHeader_1x03_P2.54mm_Vertical
JP7: Z_MS2; PinHeader_1x03_P2.54mm_Vertical
JP8: E0_MS2; PinHeader_1x03_P2.54mm_Vertical
JP9: X_MS3; PinHeader_1x03_P2.54mm_Vertical
JP10: Y_MS3; PinHeader_1x03_P2.54mm_Vertical
JP11: Z_MS3; PinHeader_1x03_P2.54mm_Vertical
JP12: E0_MS3; PinHeader_1x03_P2.54mm_Vertical
JP13: X_RST; PinHeader_1x03_P2.54mm_Vertical
JP14: Y_RST; PinHeader_1x03_P2.54mm_Vertical
JP15: Z_RST; PinHeader_1x03_P2.54mm_Vertical
JP16: E0_RST; PinHeader_1x03_P2.54mm_Vertical
L1: 4.7uH4.5A; SMMS0530
Q1: IRLS3034PBF; TO-263-2
Q2, Q3: IRLR8743TRPBF; TO-252-2
Q4, Q5: S9014; SOT-23
R1, R2, R26, R27: 0R; R_0805_2012Metric
R3, R4, R8, R32: 10K; R_0805_2012Metric
R5, R7, R9, R12, R30, R31: 2.2K; R_0805_2012Metric
R6, R38: 1.5K; R_0805_2012Metric
R10, R13: 10R; R_0805_2012Metric
R11, R14: 100K; R_0805_2012Metric
R15, R22, R23: 12K; R_0805_2012Metric
R16, R17, R19, R20: 4.7K; R_0805_2012Metric
R18: 73.2K; R_0805_2012Metric
R21: 23.7K; R_0805_2012Metric
R24: 60.4K; R_0805_2012Metric
R25: 11.5K; R_0805_2012Metric
R28: 220R; R_0805_2012Metric
R29, R36: 330R; R_0805_2012Metric
R35: 1K; R_0805_2012Metric
SW1: RESET; 6x6mmTactileSwitch
U1: ESP32-WROOM-32D; ESP32-WROOM-32
U2: TPS54340DDA; TI_SO-PowerPAD-8_ThermalVias
U3: CH340C; SOIC-16_3.9x9.9mm_P1.27mm
U4: AMS1117-3.3; SOT-223-3_TabPin2
U5, U6, U8, U9: Pololu_board; Pololu_Breakout-16_15.2x20.3mm
U10: TLP182; MFSOP6-4_4.4x3.6mm_P1.27mm
U11, U12: 74LVC1G125; SOT-353_SC-70-5

Connections:
5V1: C12.2, D14.2 (A), L1.2, R24.1
+3V3: C11.2, C14.1, C19.1, J1.1, J2.1, J4.4 (VDD), J5.1, J14.1, J17.1, J18.1, JP1.1 (A), JP2.1 (A), JP3.1 (A), JP4.1 (A), JP5.1 (A), JP6.1 (A), JP7.1 (A), JP8.1 (A), JP9.1 (A), JP10.1 (A), JP11.1 (A), JP12.1 (A), R3.2, R4.2, R8.2, R15.1, R16.1, R17.1, R19.2, R20.2, R28.2, R32.1, U1.2 (VDD), U3.4 (V3), U3.16 (VCC), U4.2 (VO), U5.10 (+5V), U6.10 (+5V), U8.10 (+5V), U9.10 (+5V)
+5V: C13.1, D14.1 (K), D15.1 (K), J15.1, J15.2, R29.2, U4.3 (VI), U11.5 (VCC), U12.5 (VCC)
/D+: D8.1 (A1), J16.3 (D+), U3.5 (UD+)
/D-: D7.1 (A1), J16.2 (D-), U3.6 (UD-)
COMP: C9.1, R21.1, U2.6 (COMP)
DTR: Q5.2 (E), R22.2, U3.13 (~DTR)
E0_DIR_PIN: J19.2, U1.28 (IO17), U9.8 (DIR)
E0_MS1: JP4.2 (C), U9.2 (MS1)
E0_MS2: JP8.2 (C), U9.3 (MS2)
E0_MS3: JP12.2 (C), U9.4 (MS3)
E0_RST: JP16.2 (C), U9.5 (~RST)
E0_SLP: JP16.3 (B), U9.6 (~SLEEP)
E0_STEP_PIN: J19.3, U1.27 (IO16), U9.7 (STEP)
EN: Q4.3 (C), R15.2, SW1.2, U1.3 (EN)
FAN_E0_PIN: J19.8, U1.16 (IO13), U12.2
FB: R24.2, R25.1, U2.5 (FB)
GND: C1.1, C2.1, C3.1, C4.2, C5.1, C6.1, C7.1, C8.2, C9.2, C11.1, C12.1, C13.2, C14.2, C15.2, C16.2, C17.2, C18.2, C19.2, D5.2 (A), D7.2 (A2), D8.2 (A2), D9.2 (A), D10.1 (K), D11.1 (K), D12.1 (K), J1.2, J2.2, J4.6 (VSS), J5.2, J6.2, J8.2, J9.2, J11.2, J12.2, J13.2, J14.2, J15.3, J15.4, J16.5 (GND), J16.6 (Shield), J17.2, J19.1, JP1.3 (B), JP2.3 (B), JP3.3 (B), JP4.3 (B), JP5.3 (B), JP6.3 (B), JP7.3 (B), JP8.3 (B), JP9.3 (B), JP10.3 (B), JP11.3 (B), JP12.3 (B), JP13.1 (A), JP14.1 (A), JP15.1 (A), JP16.1 (A), Q2.3 (S), Q3.3 (S), R7.2, R11.1, R14.1, R18.1, R25.2, SW1.1, U1.1 (GND), U1.15 (GND), U1.38 (GND), U1.39, U2.7 (GND), U2.9 (GNDPAD), U3.1 (GND), U4.1 (GND), U5.9 (GND), U5.15 (GND), U6.9 (GND), U6.15 (GND), U8.9 (GND), U8.15 (GND), U9.9 (GND), U9.15 (GND), U10.3, U11.1, U11.3 (GND), U12.1, U12.3 (GND)
GNDD: D4.2 (A), D13.1 (K), J9.3, Q1.3 (S), R35.1
HEATER_BED_PIN: J19.4, R36.1, U1.26 (IO4)
HEATER_E0_PIN: J19.6, U1.24 (IO2), U11.2
IO0: J19.5, Q5.3 (C), U1.25 (IO0)
MISO: J4.7 (DAT0), J14.6, U1.31 (IO19)
MOSI: J4.3 (CMD), J14.5, U1.37 (IO23)
MOTOR_EN_PIN: J18.8, R32.2, U1.10 (IO25), U5.1 (EN), U6.1 (EN), U8.1 (EN), U9.1 (EN)
unnamed: C8.1, R21.2
unnamed: C10.1, D9.1 (K), L1.1, U2.8 (SW)
unnamed: C10.2, U2.1 (BOOT)
unnamed: D1.1 (K), J3.2, Q1.2 (D)
unnamed: D1.2 (A), R5.1
unnamed: D2.1 (K), J6.3
unnamed: D3.1 (K), J7.2, Q2.2 (D)
unnamed: D3.2 (A), R9.1
unnamed: D6.1 (K), J10.2, Q3.2 (D)
unnamed: D6.2 (A), R12.1
unnamed: D10.2 (A), R28.1
unnamed: D11.2 (A), R29.1
unnamed: D12.2 (A), R30.1
unnamed: D13.2 (A), R31.1
unnamed: F1.2, J9.1
unnamed: F2.2, J9.4
unnamed: J15.8, R6.1
unnamed: J21.1, U5.14 (2B)
unnamed: J21.2, U5.13 (2A)
unnamed: J21.3, U5.12 (1B)
unnamed: J21.4, U5.11 (1A)
unnamed: J22.1, U6.14 (2B)
unnamed: J22.2, U6.13 (2A)
unnamed: J22.3, U6.12 (1B)
unnamed: J22.4, U6.11 (1A)
unnamed: J23.1, U8.14 (2B)
unnamed: J23.2, U8.13 (2A)
unnamed: J23.3, U8.12 (1B)
unnamed: J23.4, U8.11 (1A)
unnamed: J24.1, U9.14 (2B)
unnamed: J24.2, U9.13 (2A)
unnamed: J24.3, U9.12 (1B)
unnamed: J24.4, U9.11 (1A)
unnamed: Q2.1 (G), R10.1
unnamed: Q3.1 (G), R13.1
unnamed: Q4.1 (B), R22.1
unnamed: Q5.1 (B), R23.1
unnamed: R18.2, U2.4 (RT/CLK)
unnamed: R26.2, U3.2 (TXD)
unnamed: R27.2, U3.3 (RXD)
unnamed: R36.2, U10.1
unnamed: R38.2, U10.4
RTS: Q4.2 (E), R23.2, U3.14 (~RTS)
SCK: J4.5 (CLK), J14.7, U1.30 (IO18)
SCL: J14.3, R20.1, U1.36 (IO22)
SDA: J14.4, R19.1, U1.33 (IO21)
SS: J4.2 (DAT3/CD), J14.8, U1.29 (IO5)
TEMP_BED_PIN: C5.2, J12.1, J18.3, R16.2, U1.5 (SENSOR_VN)
TEMP_E0_PIN: C6.2, J13.1, J18.2, R17.2, U1.4 (SENSOR_VP)
TO_FAN_E0: R13.2, R14.2, U12.4
TO_HEATER_BED: Q1.1 (G), R35.2, R38.1
TO_HEATER_E0: R10.2, R11.2, U11.4
UART+: R1.1, R27.1, U1.35 (TXD0/IO1)
UART-: R2.1, R26.1, U1.34 (RXD0/IO3)
UARTD+: J15.6, J17.3, R1.2
UARTD-: J17.4, R2.2, R6.2, R7.1
VBED: D4.1 (K), F2.1, J3.1, R5.2, R31.2, U10.6
VIN: C4.1, C7.2, C15.1, C16.1, C17.1, C18.1, D5.1 (K), F1.1, J6.1, J7.1, J8.1, J10.1, J11.1, R9.2, R12.2, R30.2, U2.2 (VIN), U5.16 (+12V), U6.16 (+12V), U8.16 (+12V), U9.16 (+12V)
VUSB: D15.2 (A), J16.1 (VBUS)
X_DIR_PIN: J18.9, U1.11 (IO26), U5.8 (DIR)
X_MIN: C1.2, J1.3, J18.4, R3.1, U1.6 (IO34)
X_MS1: JP1.2 (C), U5.2 (MS1)
X_MS2: JP5.2 (C), U5.3 (MS2)
X_MS3: JP9.2 (C), U5.4 (MS3)
X_RST: JP13.2 (C), U5.5 (~RST)
X_SLP: JP13.3 (B), U5.6 (~SLEEP)
X_STEP_PIN: J18.10, U1.12 (IO27), U5.7 (STEP)
Y_DIR_PIN: J18.6, U1.8 (IO32), U8.8 (DIR)
Y_MIN: C3.2, J5.3, J18.5, R8.1, U1.7 (IO35)
Y_MS1: JP2.2 (C), U8.2 (MS1)
Y_MS2: JP6.2 (C), U8.3 (MS2)
Y_MS3: JP10.2 (C), U8.4 (MS3)
Y_RST: JP14.2 (C), U8.5 (~RST)
Y_SLP: JP14.3 (B), U8.6 (~SLEEP)
Y_STEP_PIN: J18.7, U1.9 (IO33), U8.7 (STEP)
Z_DIR_PIN: J19.10, U1.14 (IO12), U6.8 (DIR)
Z_MIN: C2.2, D2.2 (A), J2.3, J19.7, R4.1, U1.23 (IO15)
Z_MS1: JP3.2 (C), U6.2 (MS1)
Z_MS2: JP7.2 (C), U6.3 (MS2)
Z_MS3: JP11.2 (C), U6.4 (MS3)
Z_RST: JP15.2 (C), U6.5 (~RST)
Z_SLP: JP15.3 (B), U6.6 (~SLEEP)
Z_STEP_PIN: J19.9, U1.13 (IO14), U6.7 (STEP)

Notes on the sheet:
Microcontroller
MicroSD card
Power
Step-down: 5V
Step-down: 3.3V
Power indicator LEDs
Power input
USB to serial
5V input protection
Heater: Bed
Heater: E0
Part-cooling fan
Motor EN pullup
Stepper drivers
12V to 24V fans
Thermistors
Endstops
Reset switch
Connectors
Stepper driver jumpers
Licensed under CERN OHL v1.2
AUX1 connector

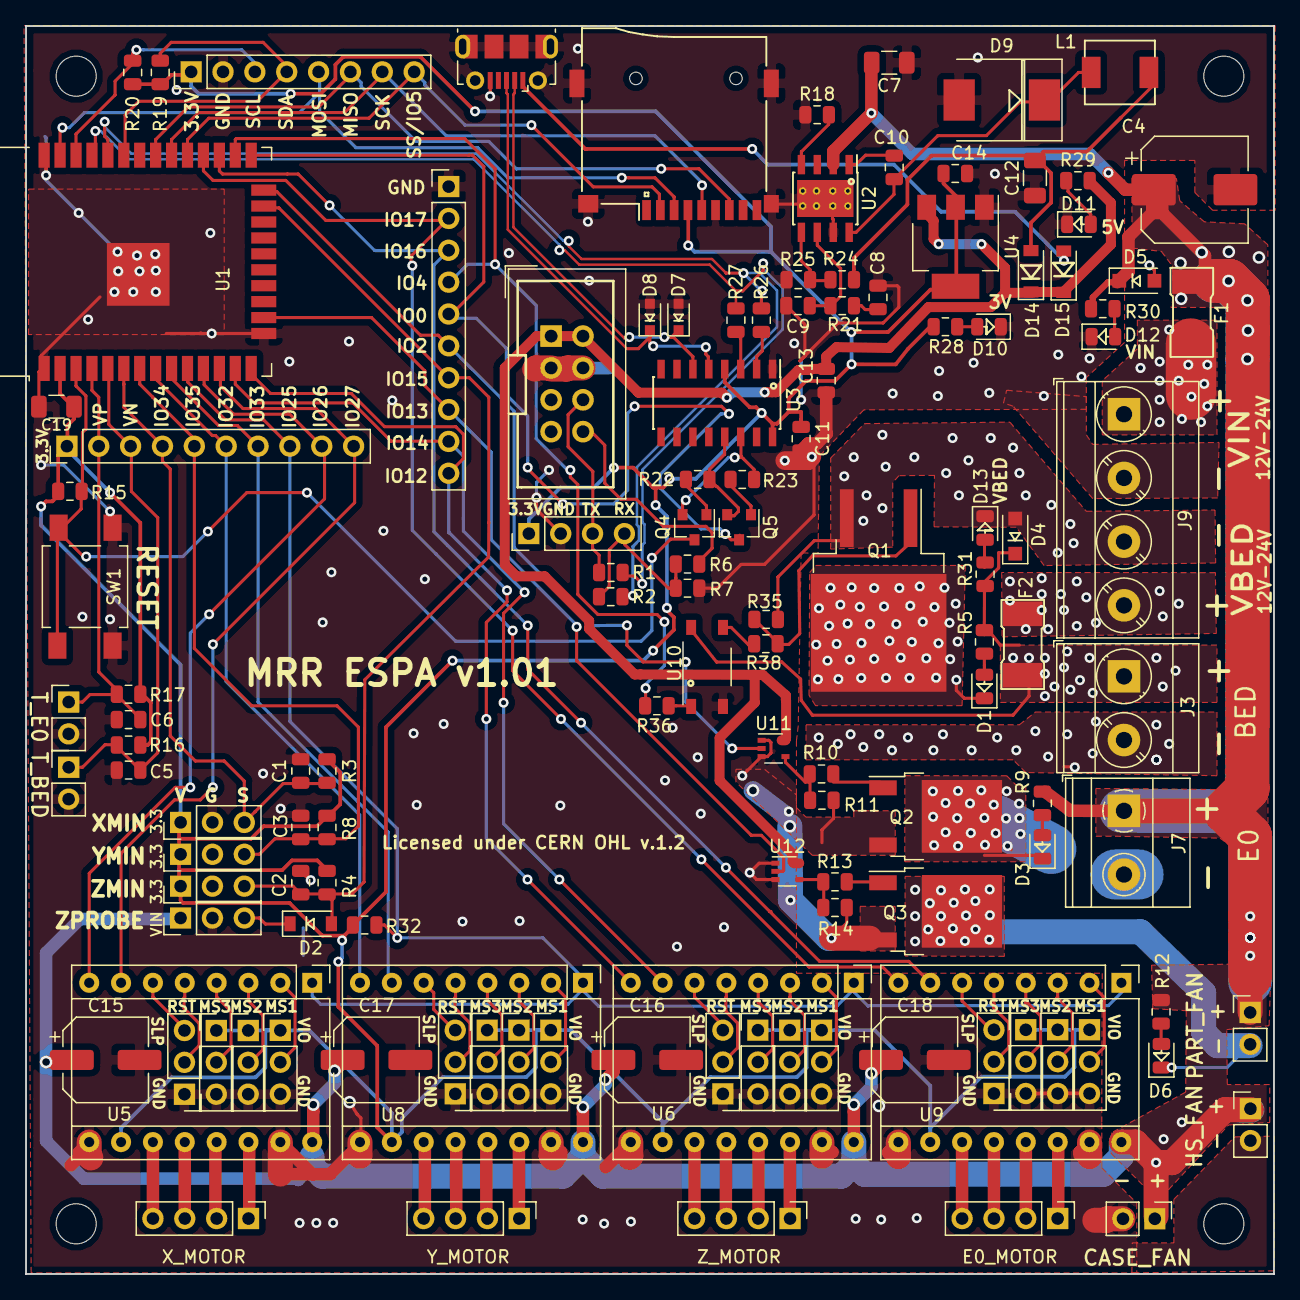
[picture p14: board MRR_ESPA.kicad_pcb from above]

Board: 2 copper layers, 99.5 x 99.5 mm, 132 parts (0 on the bottom side), 108 nets.
