vivian-ng/Hardware/(commit log)

2018-12-09 Added schematic MRR_ESP_3DP
2018-12-12 Add STM32F4 shield
2018-12-12 Add gerber file for v0.4
2018-12-13 Update copper area
    [PCB_ESP32_3DP_v3.pcbdoc]
2018-12-15 Add v0.5
    [AltiumPCB_MRR_ESP_3DP_v0.5.pcbdoc, BOM_MRR_ESP_3DP_v0.5.xls]
2018-12-15 Move to v0.4 folder
    [PCB_MRR_ESP_3DP_v0.4.pcbdoc]
2018-12-17 Update PCB letter size
2018-12-17 Move v0.5 files to v0.5 folder
    [AltiumPCB_MRR_ESP_3DP_v0.5.pcbdoc, BOM_MRR_ESP_3DP_v0.5.xls]
2018-12-18 Add v0.6 files
    [BOM_MRR_ESP_3DP_v0.6.xls, PCB_MRR_ESP_3DP_v0.6.pcbdoc]
2018-12-18 Connected 74HCT02 GND pin
    [PCB_MRR_ESP_3DP_v0.6.pcbdoc]
2018-12-18 Changed R13 value
    [BOM_MRR_ESP_3DP_v0.6.xls]
2018-12-20 Minor change to PCB
2019-01-11 Moved v0.6 files to v0.6 folder
    [BOM_MRR_ESP_3DP_v0.6.xls, PCB_MRR_ESP_3DP_v0.6.pcbdoc]
2019-01-11 Added v0.7 BOM
    [BOM_PCB_MRR_ESP_3DP_v0.7.xls]
2019-01-11 Minor change to v0,7
    [BOM_PCB_MRR_ESP_3DP_v0.7.xls]
2019-01-28 Renamed MRR_ESP32_3DP to MRR_ESPA
    [AltiumPCB_MRR_ESP_3DP_v0.5.pcbdoc, BOM_MRR_ESP_3DP_v0.5.xls, BOM_MRR_ESP_3DP_v0.6.xls, BOM_PCB_MRR_ESP_3DP_v0.7.xls, PCB_MRR_ESP_3DP_v0.4.pcbdoc, PCB_MRR_ESP_3DP_v0.6.pcbdoc]
2019-01-31 Moved v0.7 files
    [BOM_PCB_MRR_ESP_3DP_v0.7.xls]
2019-01-31 Added v0.8 files
    [MRR_ESP_3DP-B.Cu.gbl, MRR_ESP_3DP-B.Mask.gbs, MRR_ESP_3DP-B.Paste.gbp, MRR_ESP_3DP-B.SilkS.gbo, MRR_ESP_3DP-Edge.Cuts.gko, MRR_ESP_3DP-F.Cu.gtl, MRR_ESP_3DP-F.Mask.gts, MRR_ESP_3DP-F.Paste.gtp]
2019-03-11 Added v0.9
    [AltiumPCB_MRR_ESP_3DP_v0.5.pcbdoc, BOM_MRR_ESP_3DP_v0.5.xls, BOM_MRR_ESP_3DP_v0.6.xls, BOM_PCB_MRR_ESP_3DP_v0.7.xls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]
2019-04-17 Added v1.0
    [MRR_ESPA-B.Cu.gbl, MRR_ESPA-B.Mask.gbs, MRR_ESPA-B.Paste.gbp, MRR_ESPA-B.SilkS.gbo, MRR_ESPA-Edge.Cuts.gko, MRR_ESPA-F.Cu.gtl, MRR_ESPA-F.Mask.gts, MRR_ESPA-F.Paste.gtp]
2019-05-18 Added macros
    [abortabl.g, babyzdn.g, babyzup.g, endoff.g, endon.g, initsd.g, nextpt.g, queryabl.g]
2019-06-20 Added macrocfg.json
    [MRR_ESPA.csv, MRR_ESPA.kicad_pcb, MRR_ESPA.sch, nextpt.g]
